tamirmha/General-Purpose-PCB/images/20260401_105210.jpg

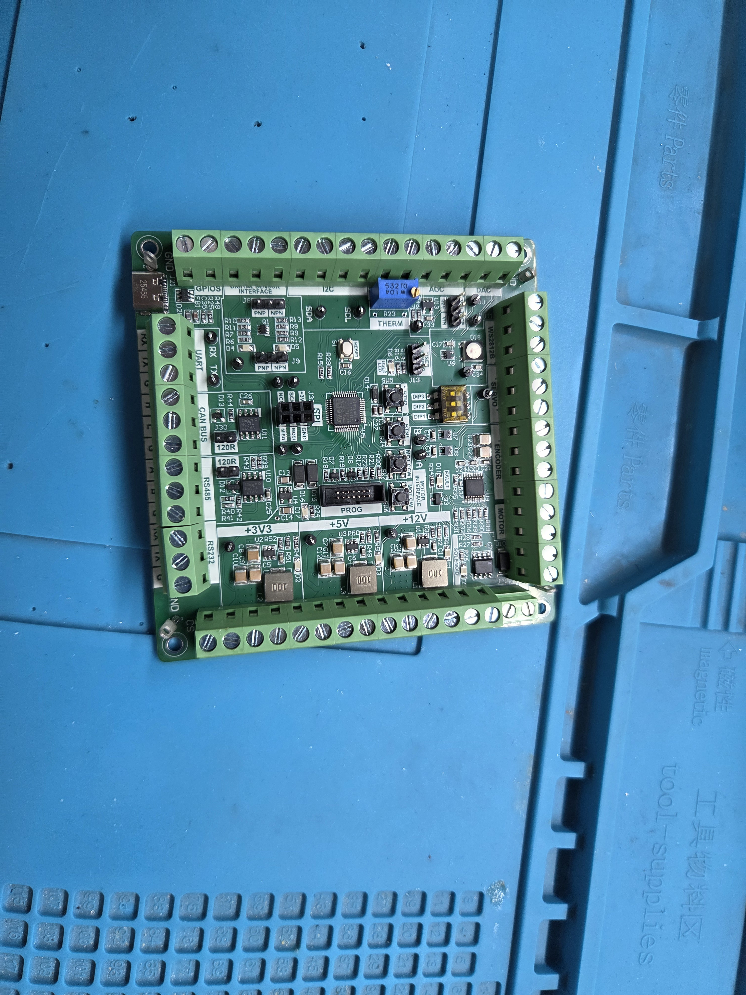
images/20260401_105210.jpg
