tamirmha/General-Purpose-PCB/Hardware/BOM_JLCPCB_PCB.xlsx

Description | Designator | Footprint | LCSC PN | Quantity
0.1 µF ±10% 100V Ceramic Capacitor X7R 0603 (1608 Metric) | C1, C5, C6, C15, C16, C17, C18, C19, C20, C21, C25, C26, C28, C29, C30, C31, C32, C33, C34 | CAP0603 | C77058 | 19
22 µF ±10% 25V Ceramic Capacitor X7R 1210 (3225 Metric) | C2, C3, C4, C7, C8, C9, C10, C11, C12, C22, C23 | CAP1210 | C21397 | 11
1 µF ±10% 35V Ceramic Capacitor X7R 0805 (2012 Metric) | C13, C14 | CAP0805 | C440196 | 2
0.022 µF ±10% 100V Ceramic Capacitor X7R 0603 (1608 Metric) | C24 | CAP0603 | C161234 | 1
4.7 µF ±10% 16V Ceramic Capacitor X7R 0603 (1608 Metric) | C27, C35 | CAP0603 | C389010 | 2
Green 570nm LED Indication - Discrete 2.2V 0805 (2012 Metric) | D1, D2, D3, D4, D5, D6, D9, D17 | LED0805 | C2899888 | 8
16V Clamp 9.37A (8/20µs) Ipp Tvs Diode Surface Mount SC-70-3 (SOT323) | D7, D8 | SC70-3(SOT-323) | C232543 | 2
DIODE SCHOTTKY 40V 3A SMA | D10, D15, D16 | SMA(DO-214AC) | C168859 | 3
Red 633nm LED Indication - Discrete 2V 0805 (2012 Metric) | D11 | LED0805 | C2899997 | 1
RS-485 , 26V, 14V Clamp 17A (8/20µs) Ipp Tvs Diode Surface Mount SOT-23-3 | D12 | SOT23 | C404012 | 1
CAN, CAN FD, TVS Clamp 4A (8/20µs) Ipp Tvs Diode Surface Mount SC-70 | D13 | SOT23 | C3713903 | 1
DIODE ZENER 3.3V 500MW SOD123 | D14 | SOD123 | C151564 | 1
WS2812B - ADDRESSABLE LED RED/GRN/BLUE | D18 | LED5050 | C114586 | 1
DIODE ZENER 9.1V 500MW SOD123 | D19 | SOD123 | C260913 | 1
USB2.0 Data and VBUS, ESD Protection, 17V Clamp 5A (8/20µs) Ipp Tvs Diode Surface Mount SOT-23-6 | D20 | SOT23-6 | C7519 | 1
120 Ohms @ 100 MHz 1 Power Line Ferrite Bead 0603 (1608 Metric) 3A 30mOhm | FB1 | FER0603 | C85831 | 1
TB 5.00mm 2POS TH 18A, 300V, 12-26 AWG Wire | J1, J2, J3, J4, J5, J6, J12, J15, J18, J19, J20, J25, J26, J27 | 1935161 | C3819953 | 14
TB 5.00mm 3POS TH 18A, 300V, 12-26 AWG Wire | J7, J14, J16, J17, J22, J23, J24, J29, J31, J33 | 1935174 | C3816891 | 10
Connector Header Through Hole 3 position 0.100" (2.54mm) | J8, J9, J13, J34 | 3P-2.54mm-MalePins | C5346215 | 4
Connector Header Through Hole 14 position 0.050" (1.27mm) | J11 | 20021511-00014T4LF |  | 1
USB-C (USB TYPE-C) USB 2.0 Receptacle Connector 24 (16+8 Dummy) Position Surface Mount, Right Angle; Through Hole | J21 | 2171790001 | C3197684 | 1
Connector Header Through Hole 2 position 0.100" (2.54mm) | J28, J30 | 2P-2.54mm-MalePins | C2931354 | 2
6 Position Header Connector 0.100" (2.54mm) Through Hole Tin | J32 | 3PX2_2.54MM HEADER |  | 1
10 µH Shielded Drum Core, Wirewound Inductor 4 A 78.5mOhm Max Nonstandard | L1, L2, L3 | SRN6540 | C780191 | 3
MOSFET N/P-CH 30V 0.65A SOT363 | Q1 | SOT363 | C155499 | 1
MOSFET N-CH 60V 9.2A SO-8 | Q2 | SO-8 | C151586 | 1
MOSFET P-CH 50V 130MA SOT23-3 | Q3 | SOT23 | C85202 | 1
MOSFET P-CH 60V 7.2A/23.6A TO252 | Q4 | TO252(DPAK) | C260900 | 1
3.01 kOhms ±1% 0.1W, 1/10W Chip Resistor 0603 (1608 Metric) Moisture Resistant Thick Film | R1 | RES0603 | C137732 | 1
140 kOhms ±1% 0.1W, 1/10W Chip Resistor 0603 (1608 Metric) Moisture Resistant Thick Film | R2 | RES0603 | C185372 | 1
10 kOhms ±1% 0.1W, 1/10W Chip Resistor 0603 (1608 Metric) Moisture Resistant Thick Film | R3, R14, R31, R32, R38, R39, R43, R47, R53 | RES0603 | C98220 | 9
220 Ohms ±1% 0.1W, 1/10W Chip Resistor 0603 (1608 Metric) Moisture Resistant Thick Film | R4, R5, R6, R8, R11, R12, R16, R24, R27 | RES0603 | C107696 | 9
4.7 kOhms ±1% 0.1W, 1/10W Chip Resistor 0603 (1608 Metric) Moisture Resistant Thick Film | R7, R9, R10, R13, R15, R28, R29, R30 | RES0603 | C99782 | 8
22 Ohms ±1% 0.1W, 1/10W Chip Resistor 0603 (1608 Metric) Moisture Resistant Thick Film | R17, R18, R19 | RES0603 | C107701 | 3
100 Ohms ±1% 0.1W, 1/10W Chip Resistor 0603 (1608 Metric) Moisture Resistant Thick Film | R20 | RES0603 | C105588 | 1
0 Ohms Jumper Chip Resistor 0603 (1608 Metric) Moisture Resistant Thick Film | R21, R22, R33, R35, R45 | RES0603 | C100044 | 5
TRIMMER 100K OHM 0.5W PC PIN TOP | R23 | Potentiometer-3296W | C48084 | 1
5.1 kOhms ±1% 0.1W, 1/10W Chip Resistor 0603 (1608 Metric) Moisture Resistant Thick Film | R25, R48 | RES0603 | C105580 | 2
2.94 kOhms ±1% 0.1W, 1/10W Chip Resistor 0603 (1608 Metric) Moisture Resistant Thick Film | R26 | RES0603 | C137748 | 1
590 Ohms ±1% 0.1W, 1/10W Chip Resistor 0603 (1608 Metric) Moisture Resistant Thick Film | R34, R36 | RES0603 | C273786 | 2
120 Ohms ±1% 0.1W, 1/10W Chip Resistor 0603 (1608 Metric) Moisture Resistant Thick Film | R40, R44 | RES0603 | C114640 | 2
10 Ohms ±1% 0.1W, 1/10W Chip Resistor 0603 (1608 Metric) Moisture Resistant Thick Film | R41, R42 | RES0603 | C109318 | 2
20 kOhms ±1% 0.1W, 1/10W Chip Resistor 0603 (1608 Metric) Moisture Resistant Thick Film | R46 | RES0603 | C105575 | 1
162 kOhms ±1% 0.1W, 1/10W Chip Resistor 0603 (1608 Metric) Moisture Resistant Thick Film | R49 | RES0603 | C165760 | 1
30.9 kOhms ±1% 0.1W, 1/10W Chip Resistor 0603 (1608 Metric) Moisture Resistant Thick Film | R50 | RES0603 | C137744 | 1
196 kOhms ±1% 0.1W, 1/10W Chip Resistor 0603 (1608 Metric) Moisture Resistant Thick Film | R51 | RES0603 | C273761 | 1
62 kOhms ±1% 0.1W, 1/10W Chip Resistor 0603 (1608 Metric) Moisture Resistant Thick Film | R52 | RES0603 | C137694 | 1
SWITCH TACTILE SPST-NO 0.05A 12V | S1 | PTS815SJM250SMTRLFS | C2689510 | 1
SWITCH SLIDE DIP SPST 0.1A 20V | SW3 | 219-3LPSTR | C2961925 | 1
SWITCH TACTILE SPST-NO 0.05A 12V | SW4, SW5, SW6, SW7 | PTS647SN38SMTR2 LFS | C2799279 | 4
TEST POINT RING, BACK - TH | TP1, TP2, TP3, TP4, TP7, TP8, TP11, TP12, TP13, TP14, TP15, TP16, TP17, TP18, TP19, TP20, TP21, TP26, TP27 | 5001 | C238122 | 19
PC TEST POINT LOOP | TP22, TP23, TP24, TP25 | 4952 | C238118 | 4
IC REG BUCK ADJ 2A TSOT23-6 | U1, U2, U3 | TSOT26 (TSOT-23-6) | C2071868 | 3
Linear Voltage Regulator IC Positive Fixed 1 Output 250mA SOT-23-5 | U4 | SOT23-5 | C80670 | 1
ARM® Cortex®-M0+ STM32G0 Microcontroller IC 32-Bit 64MHz 128KB (128K x 8) FLASH 48-LQFP (7x7) | U5 | LQFP-48(7x7) | C2847904 | 1
Logic Level Shifter, 5V <> 3.3V, Single Supply, SOT-23 | U6, U7, U8 | SC-70-5 | C78541 | 3
Unipolar Motor Driver NMOS PWM 16-HTSSOP | U9 | HTSSOP-16 | C575551 | 1
1/1 Transceiver Half RS422, RS485 8-SOIC | U10 | SOIC-8 | C58890 | 1
1/1 Transceiver Half CANbus 8-SOIC | U11 | SOIC-8 | C30530 | 1
2/2 Transceiver Full RS232 16-TSSOP | U12 | TSSOP-16 | C406863 | 1
Standard (General Purpose) Amplifier 1 Circuit Rail-to-Rail SOT-23-5, VIN 2.7V - 16V | U13 | SOT23-5 | C4368903 | 1
