tamirmha/General-Purpose-PCB/Docs/GENERAL TESTING BOARD-REV00 - Schematics.PDF

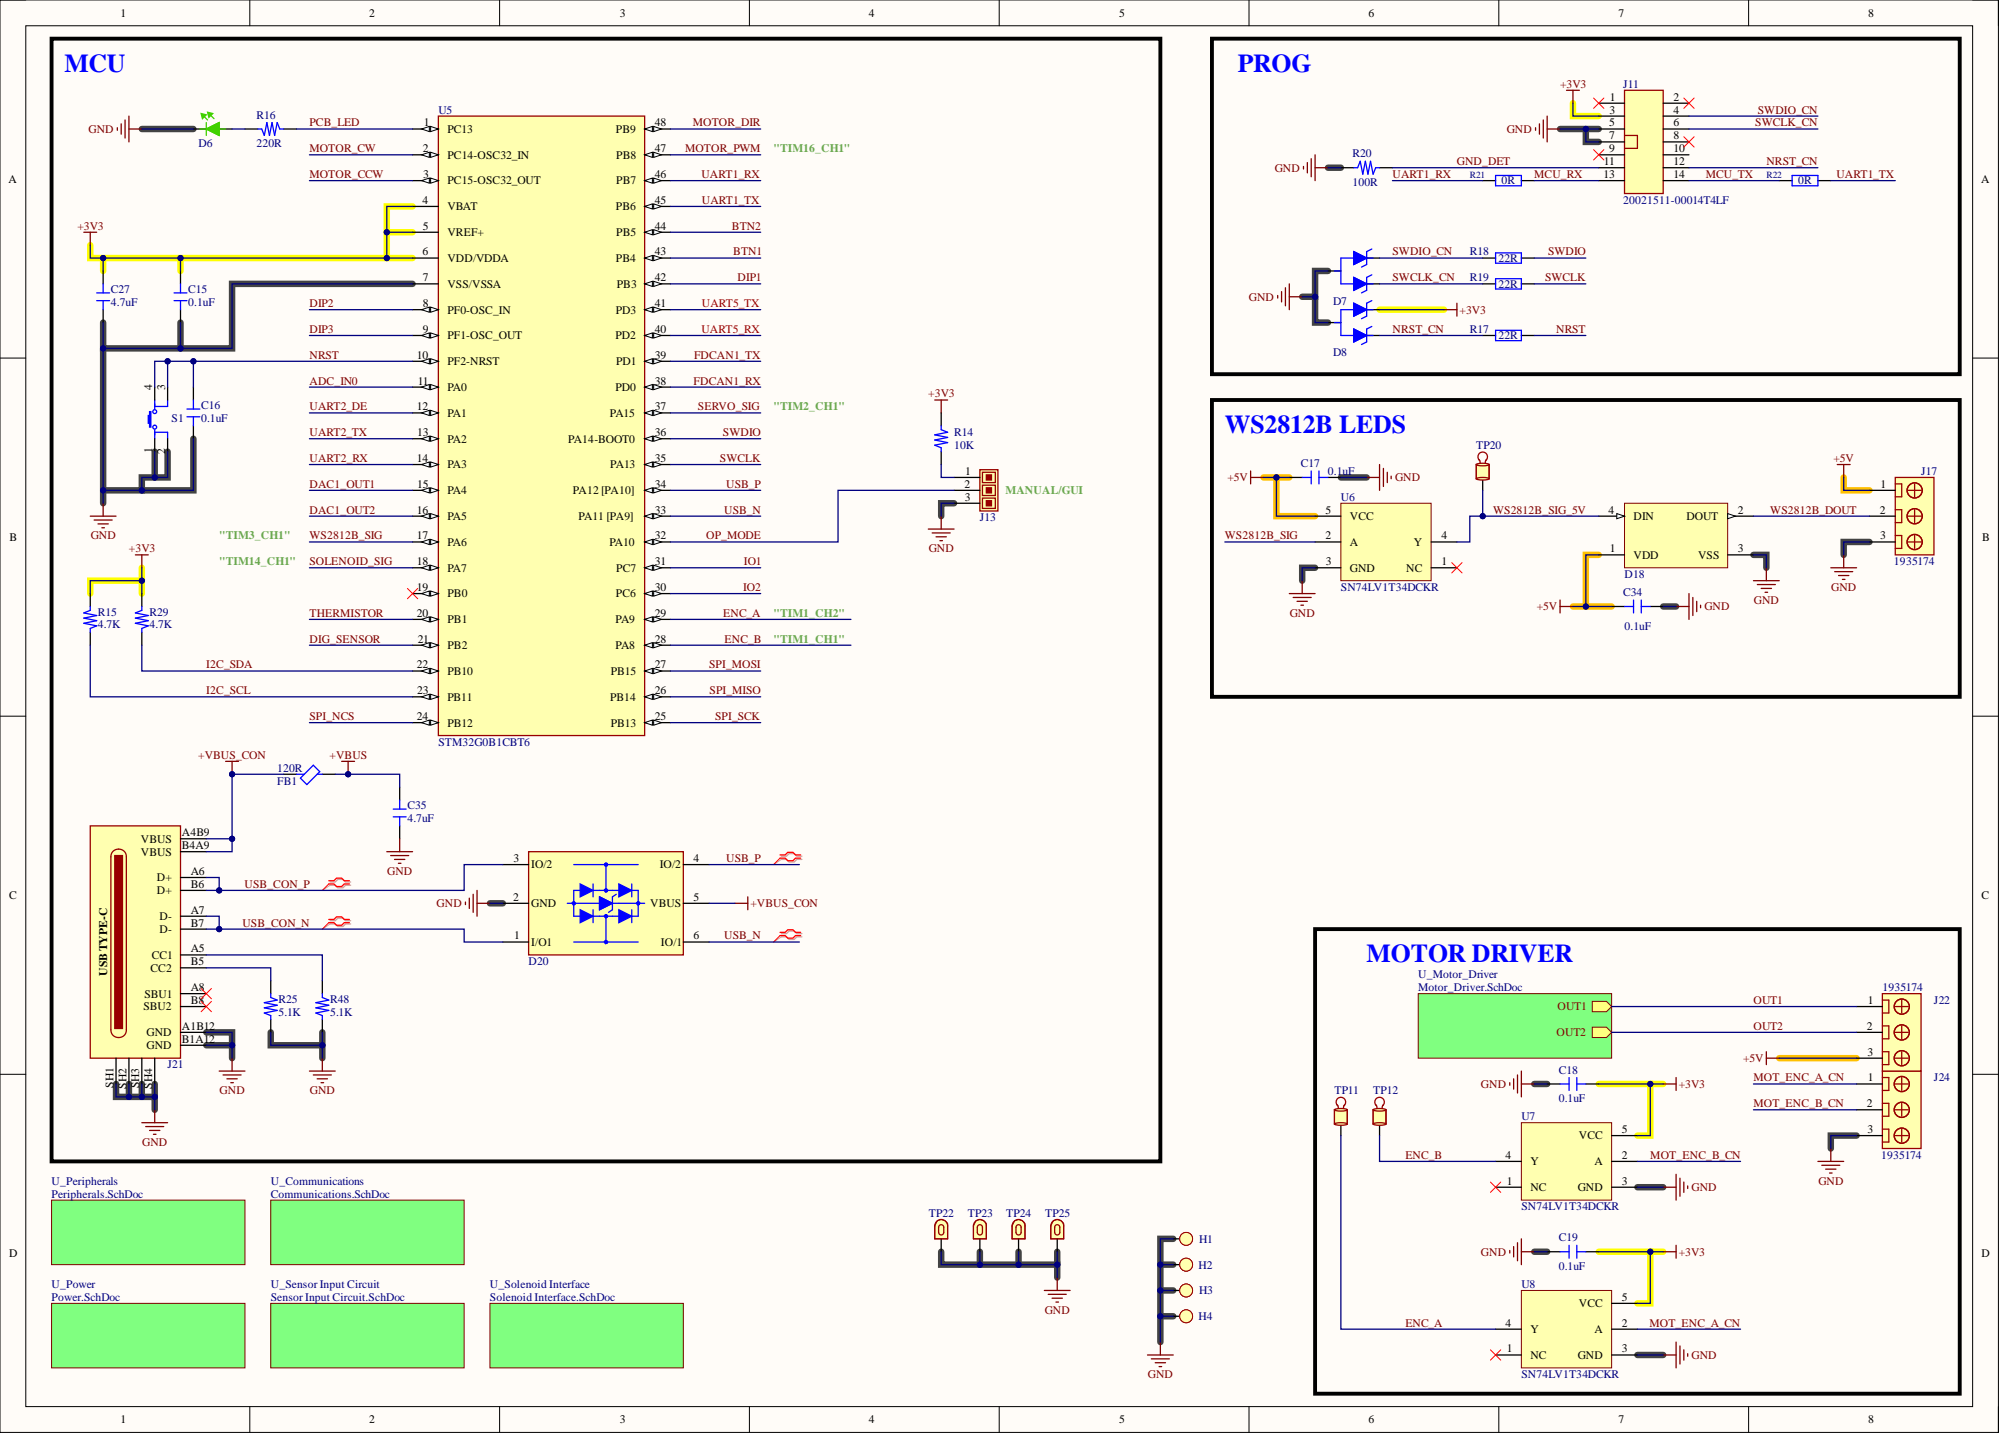
[picture p9: page 1]

VREF+ 5

VSS/VSSA 7

ADC_IN0 | | PA0 11

U_Sensor Input Circuit
Sensor Input Circuit.SchDoc

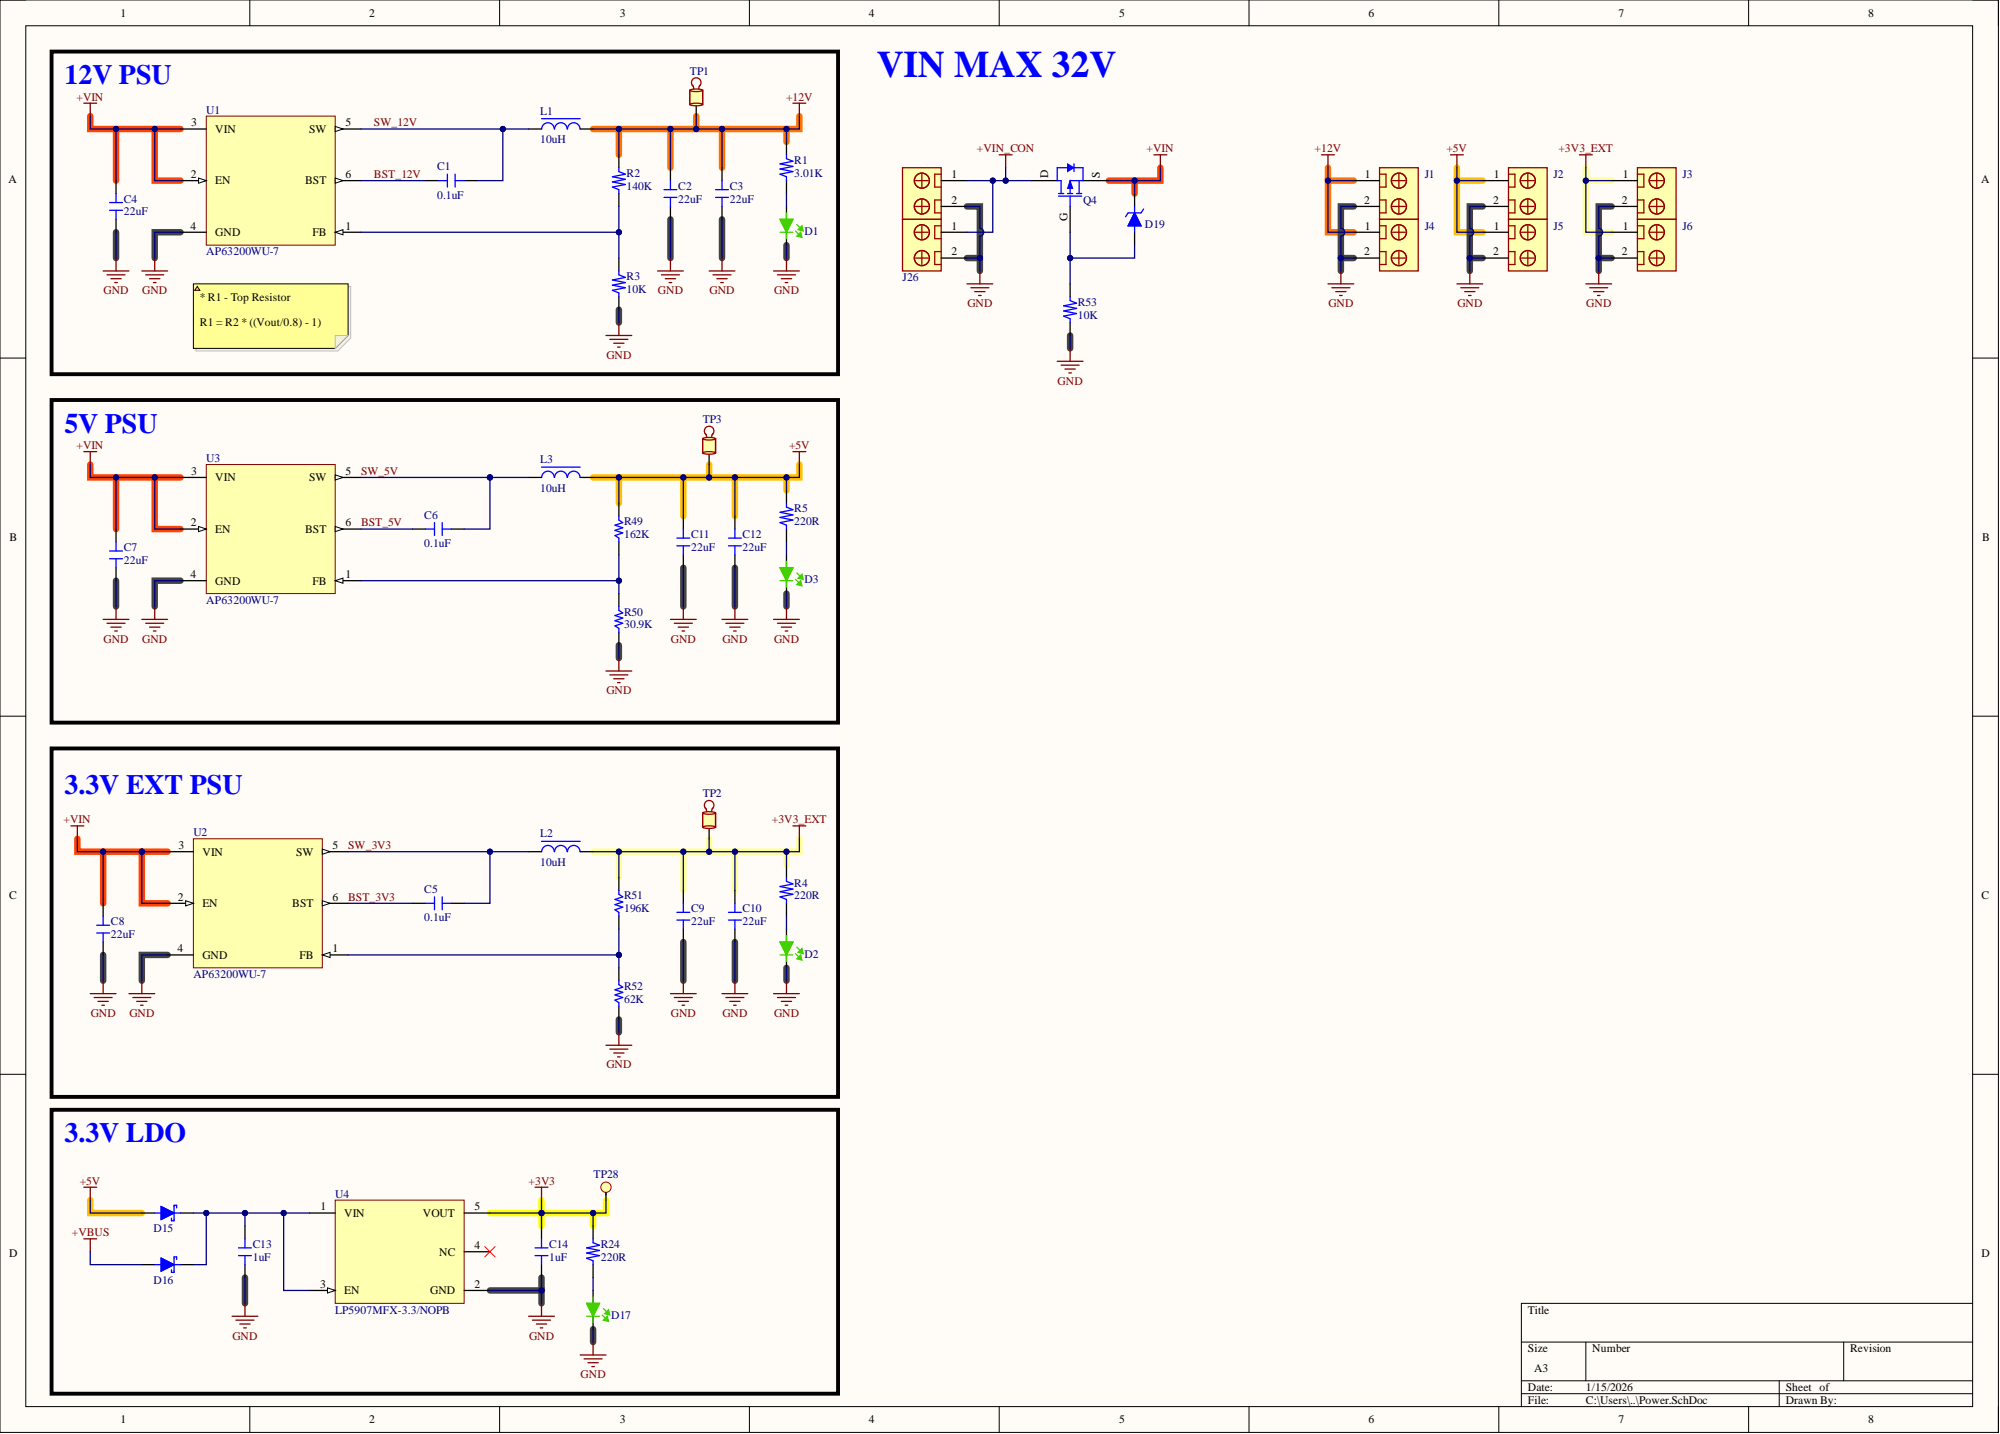
[picture p10: page 2]

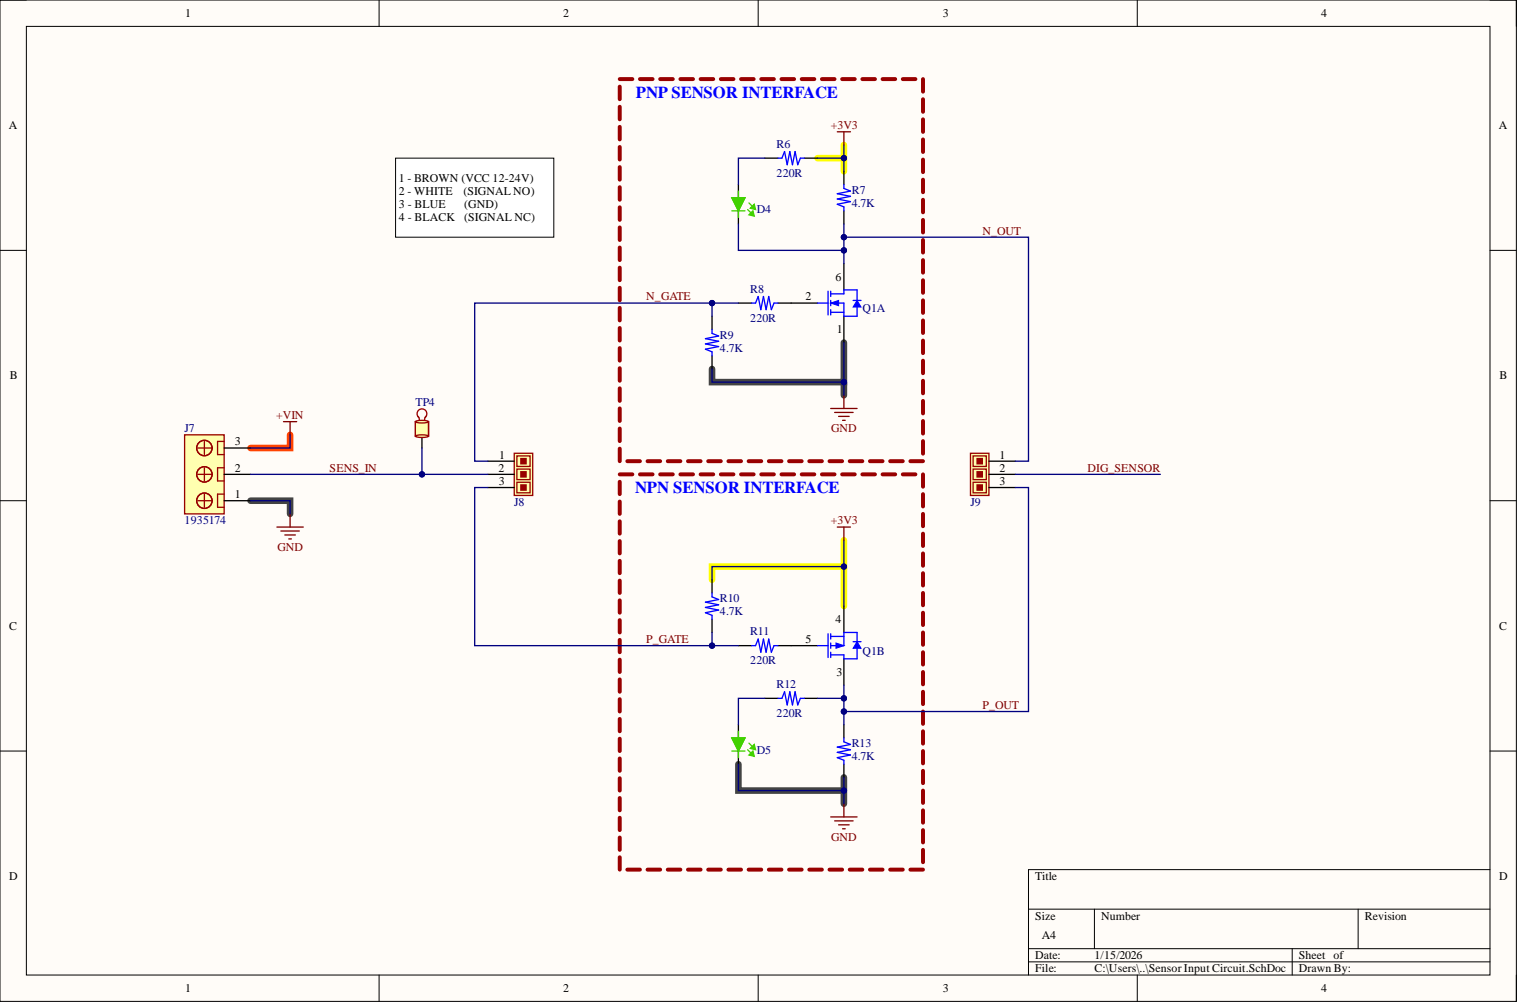
[picture p11: page 3]

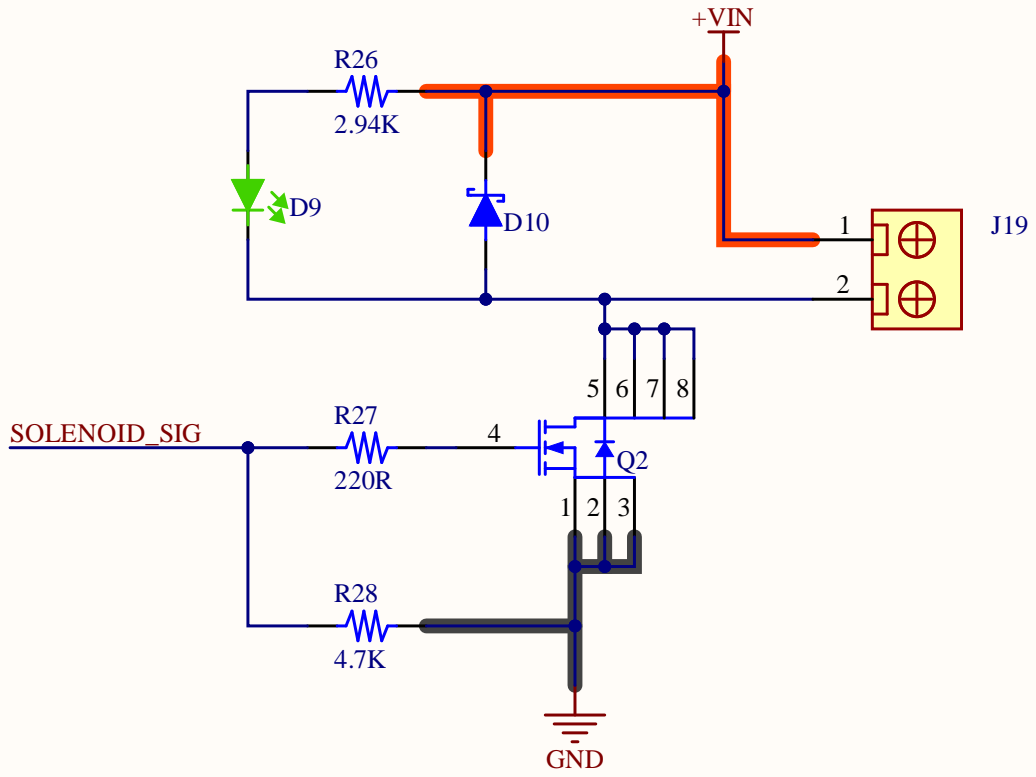
[picture p12: page 4]

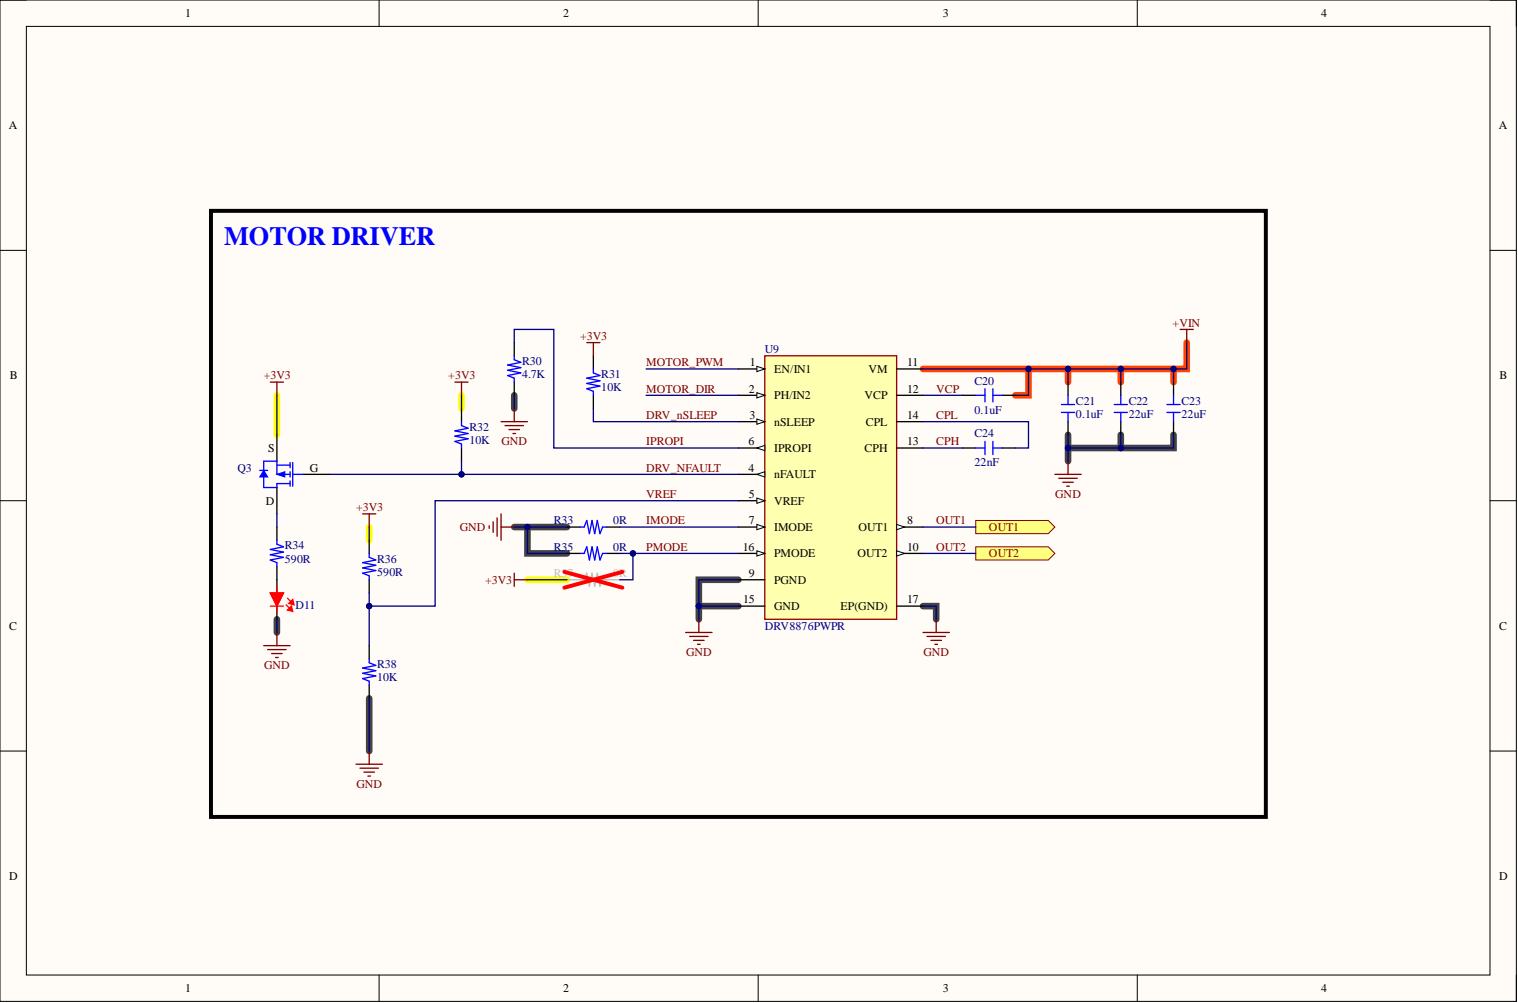
[picture p13: page 5]

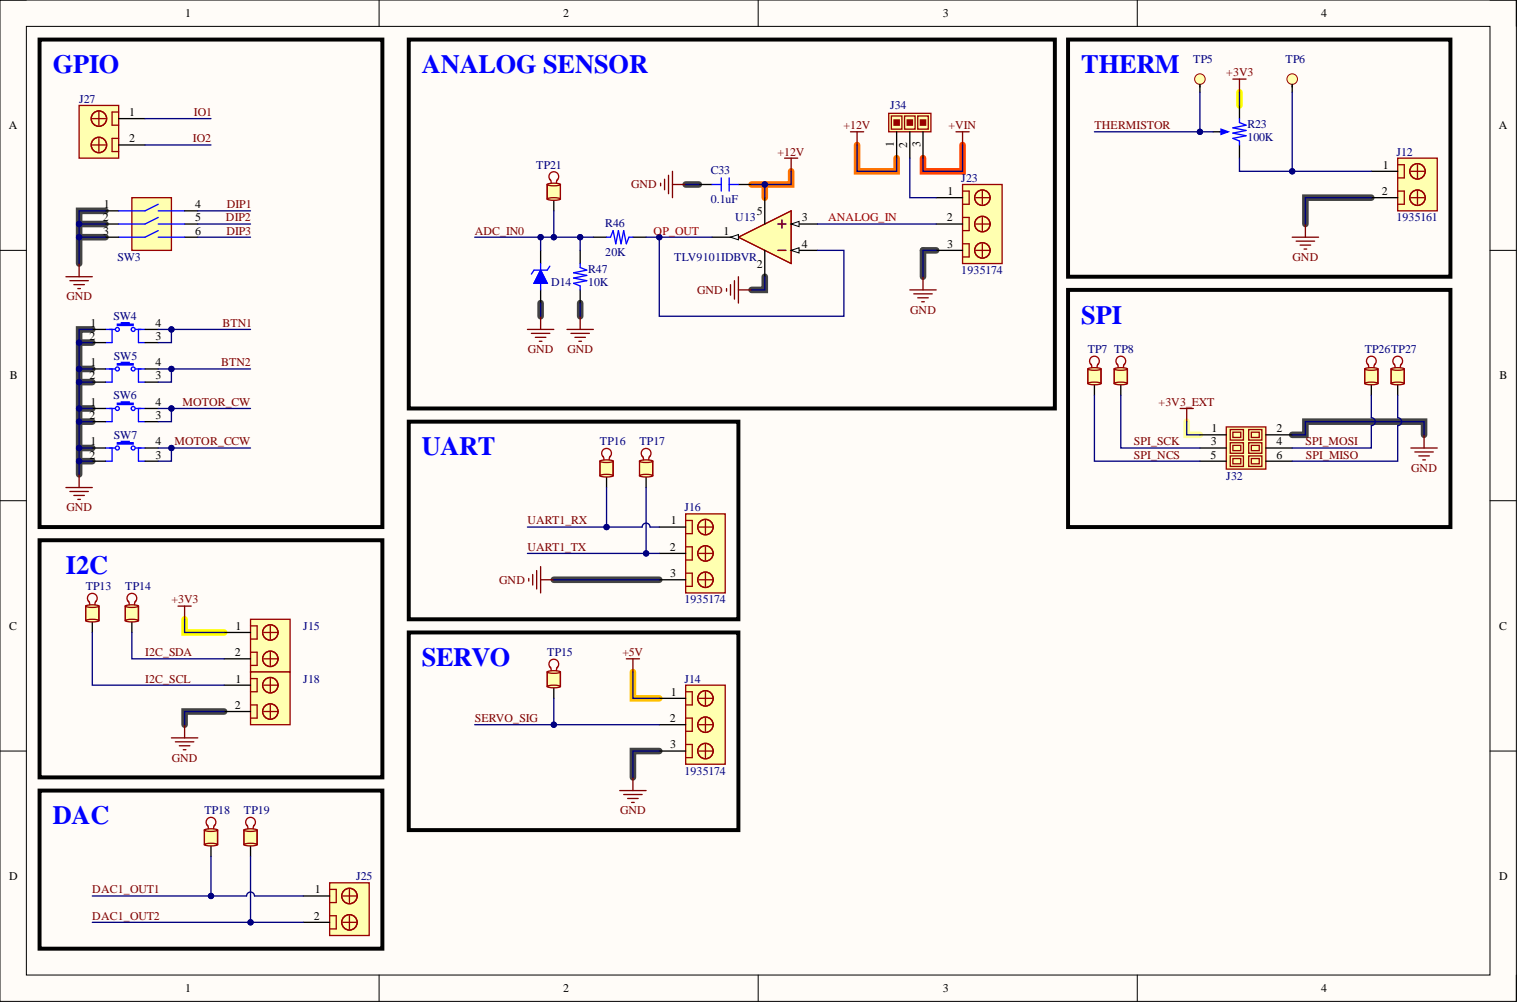
[picture p14: page 6]

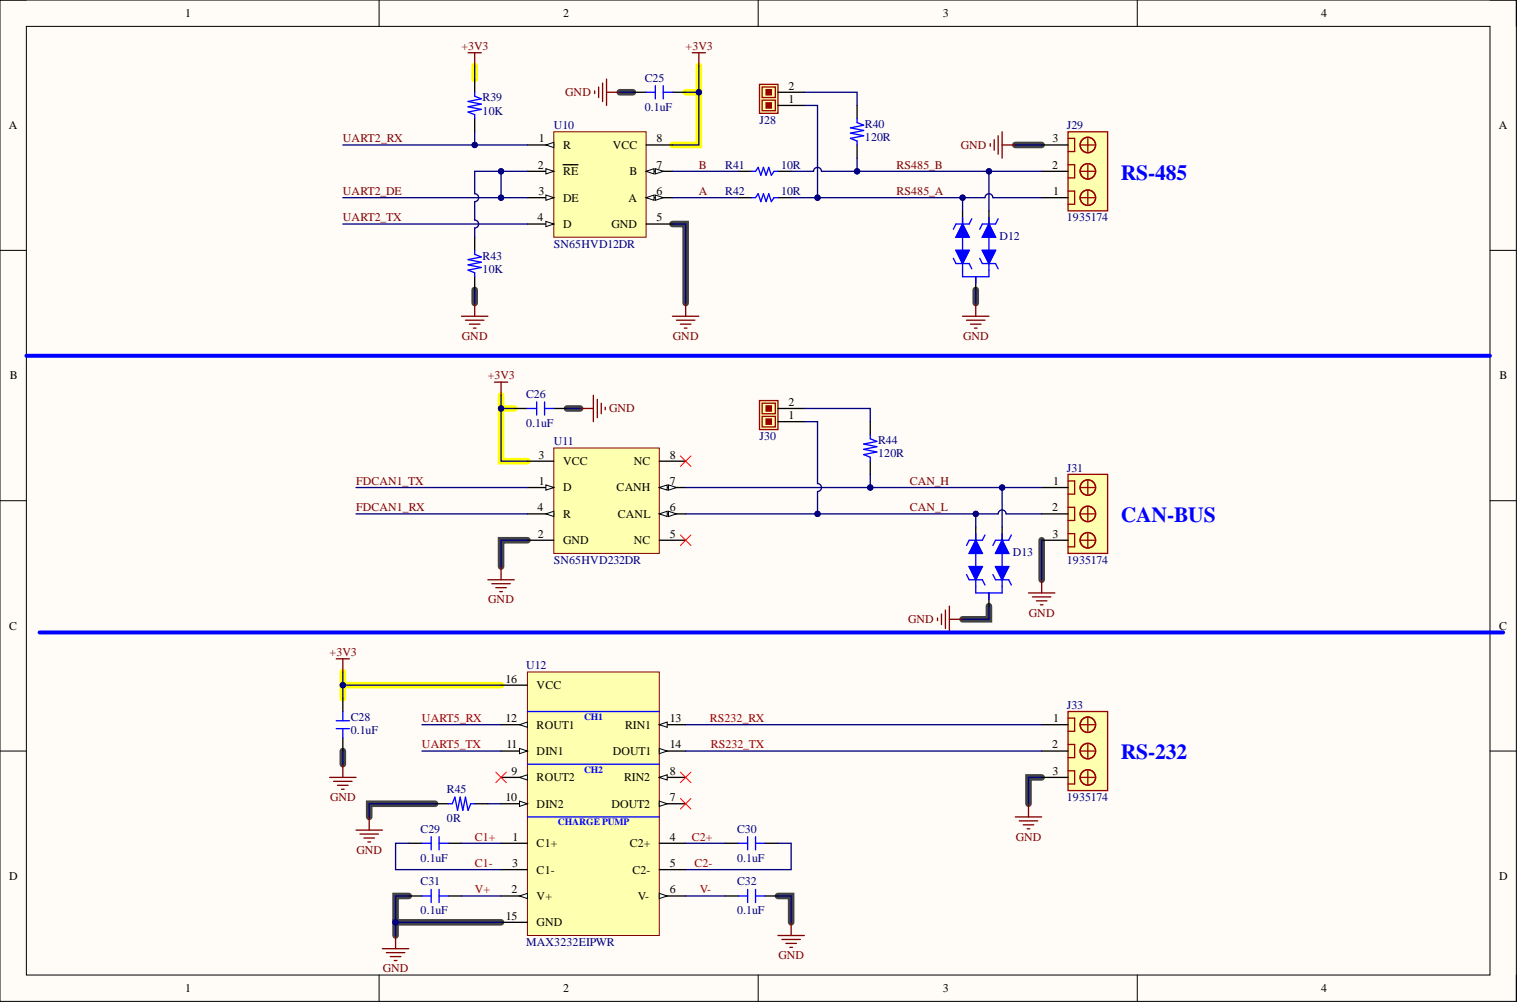
[picture p15: page 7]
