tamirmha/General-Purpose-PCB/Docs/GENERAL TESTING BOARD-REV00 - Fabrication.PDF

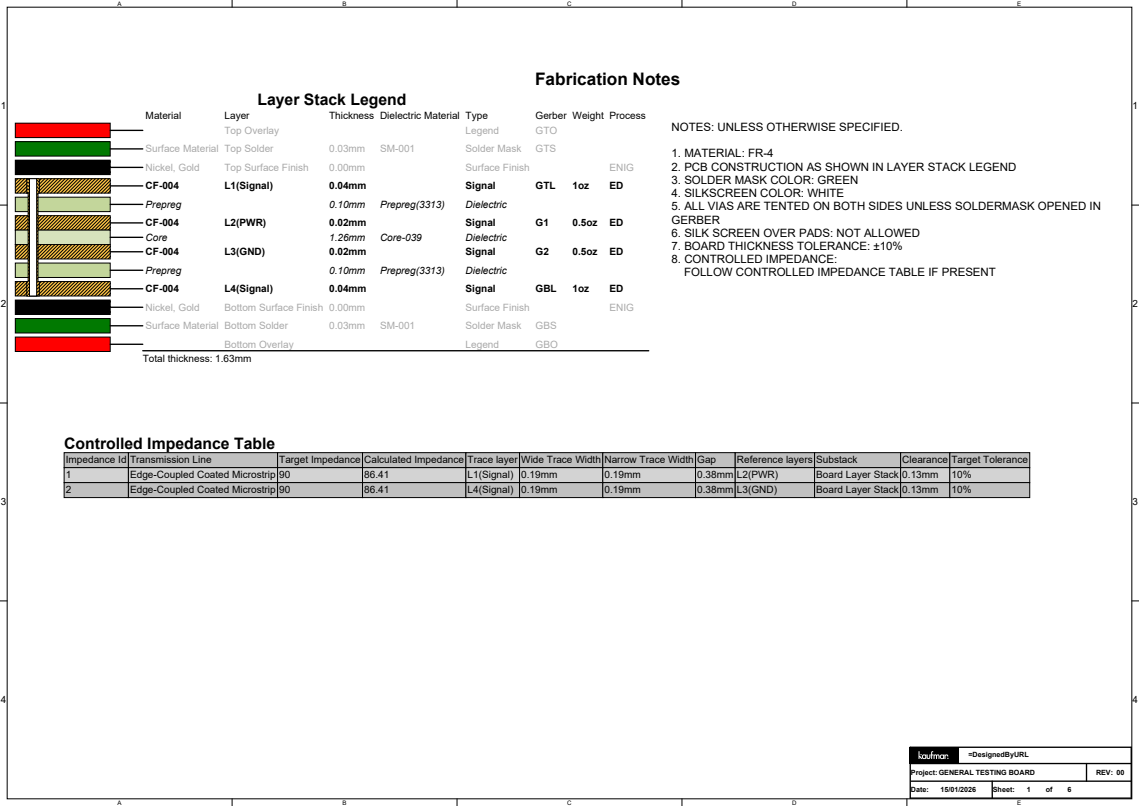
[picture p16: page 1]

NOTES: UNLESS OTHERWISE SPECIFIED.

1. MATERIAL: FR-4
2. PCB CONSTRUCTION AS SHOWN IN LAYER STACK LEGEND
3. SOLDER MASK COLOR: GREEN
4. SILKSCREEN COLOR: WHITE
5. ALL VIAS ARE TENTED ON BOTH SIDES UNLESS SOLDERMASK OPENED IN
GERBER
6. SILK SCREEN OVER PADS: NOT ALLOWED
7. BOARD THICKNESS TOLERANCE: ±10%
8. CONTROLLED IMPEDANCE:
FOLLOW CONTROLLED IMPEDANCE TABLE IF PRESENT

Impedance Id | Transmission Line | Target Impedance | Calculated Impedance | Trace layer | Wide Trace Width | Narrow Trace Width | Gap | Reference layers | Substack | Clearance | Target Tolerance
1 | Edge-Coupled Coated Microstrip | 90 | 86.41 | L1(Signal) | 0.19mm | 0.19mm | 0.38mm | L2(PWR) | Board Layer Stack | 0.13mm | 10%
2 | Edge-Coupled Coated Microstrip | 90 | 86.41 | L4(Signal) | 0.19mm | 0.19mm | 0.38mm | L3(GND) | Board Layer Stack | 0.13mm | 10%

Project:GENERAL TESTING BOARD | REV: 00

Date: 15/01/2026 | Sheet: 1 of 6

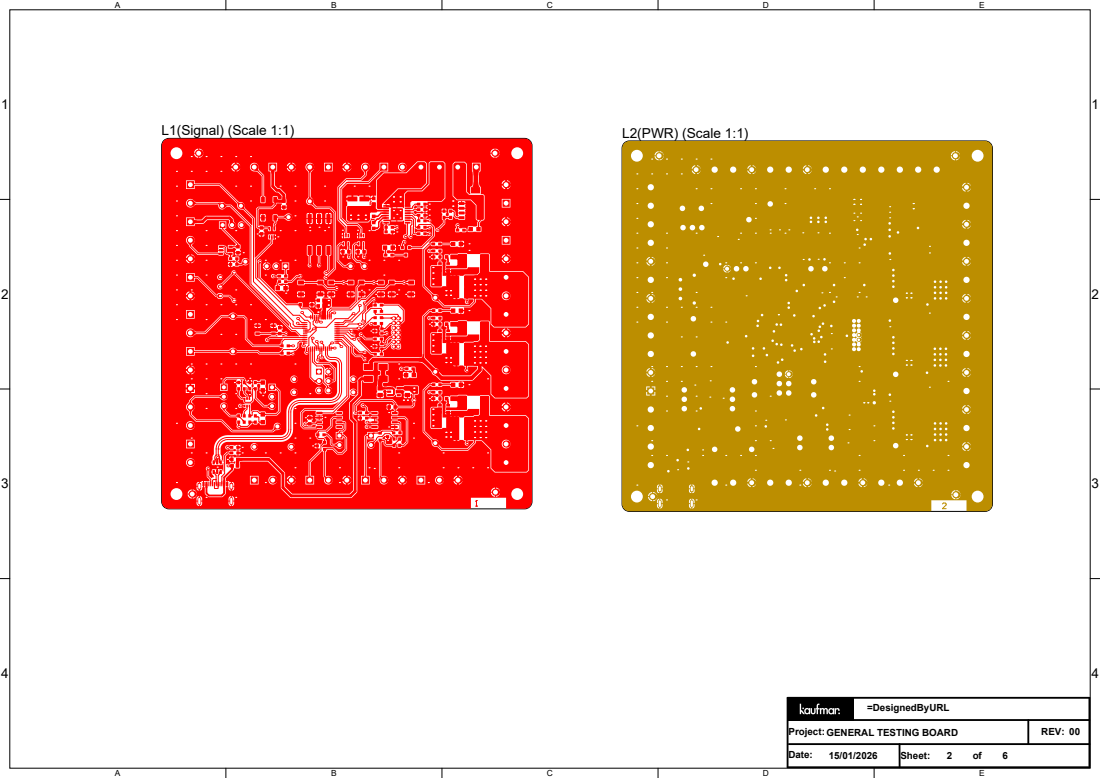
[picture p17: page 2]

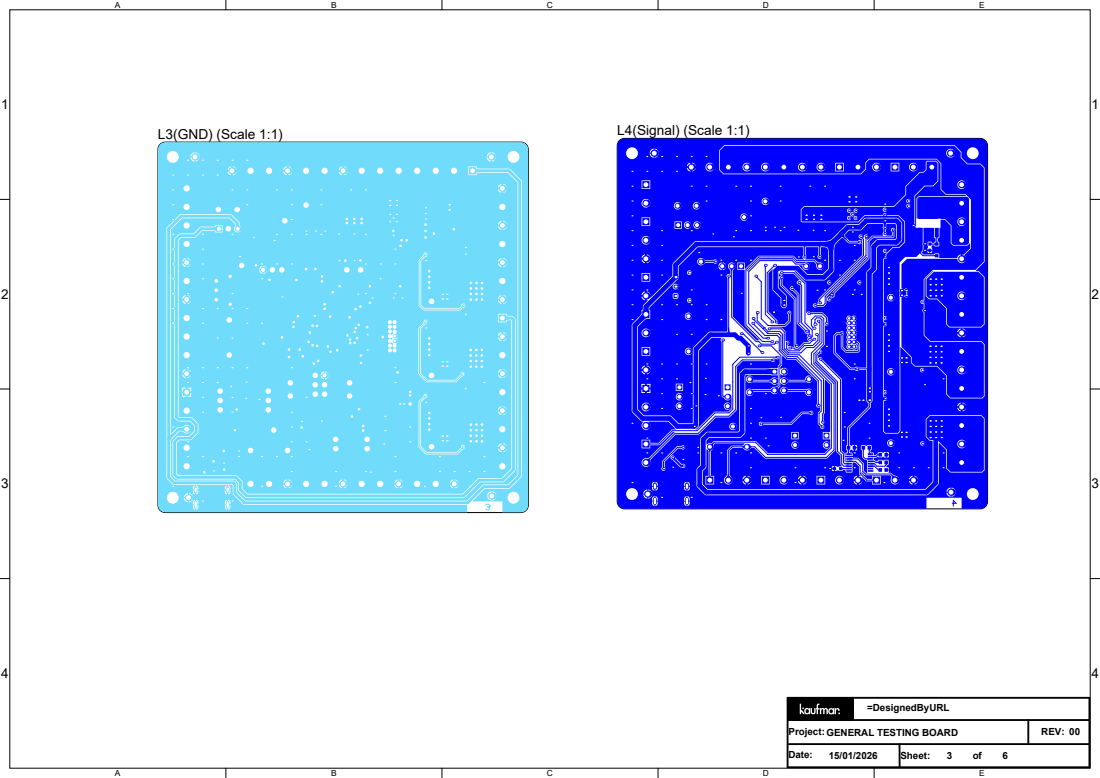
[picture p18: page 3]

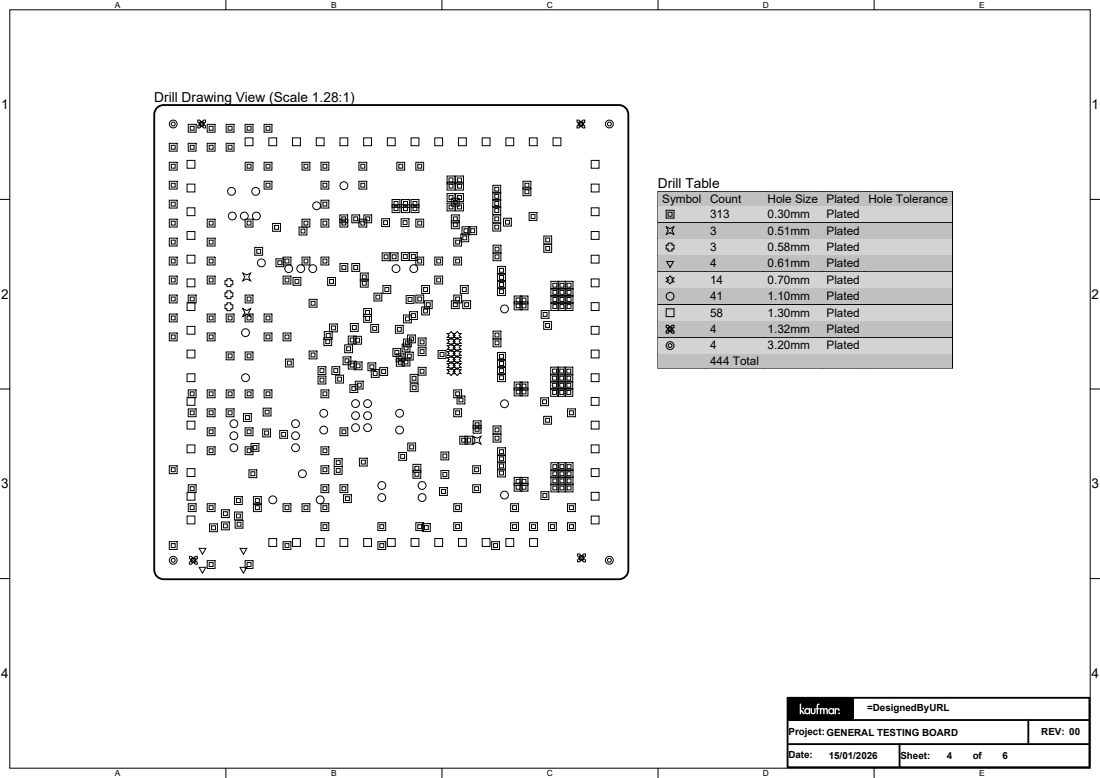
[picture p19: page 4]

Drill Drawing View (Scale 1.28:1)

Symbol | Count | Hole Size | Plated | Hole Tolerance

313 | 0.30mm | Plated
3 | 0.51mm | Plated
3 | 0.58mm | Plated
4 | 0.61mm | Plated
14 | 0.70mm | Plated
41 | 1.10mm | Plated
58 | 1.30mm | Plated
4 | 1.32mm | Plated
4 | 3.20mm | Plated
444 Total

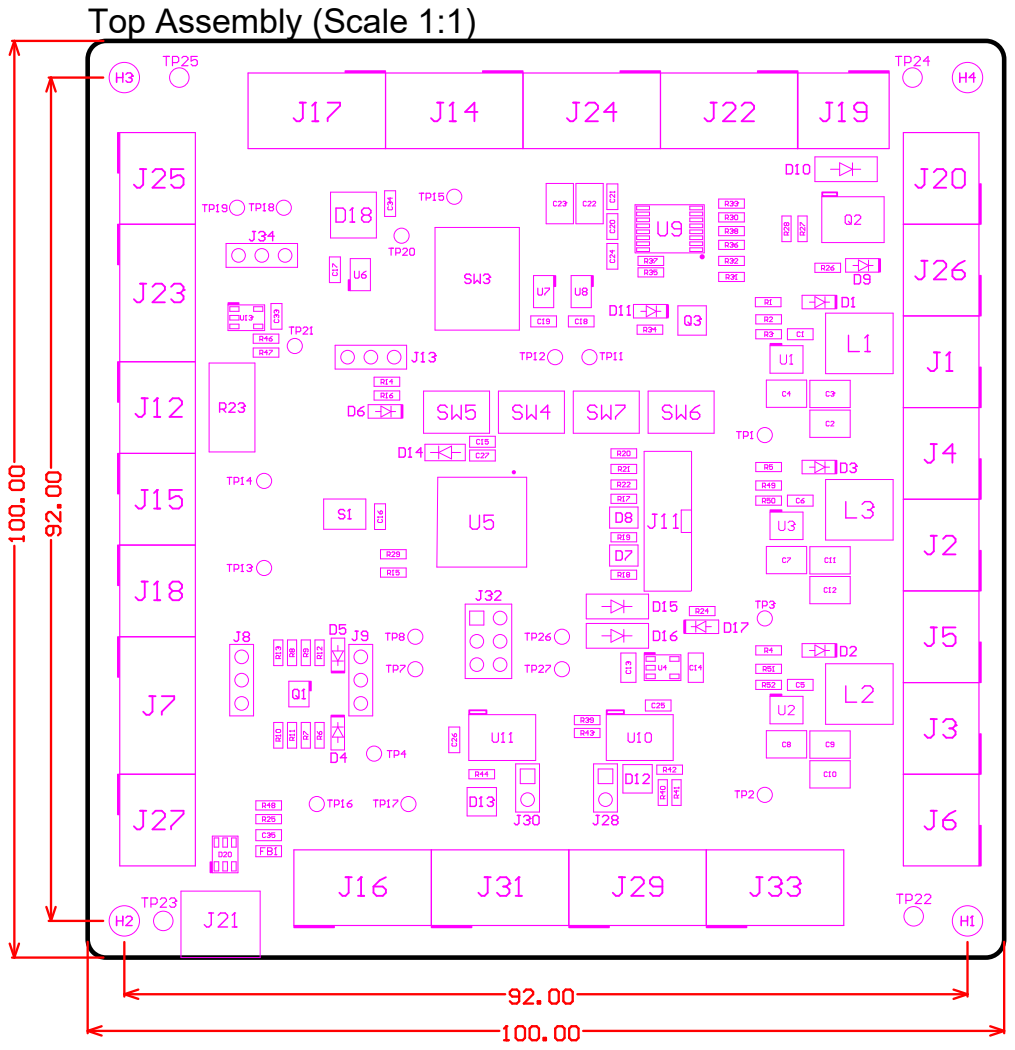
[picture p20: page 5]

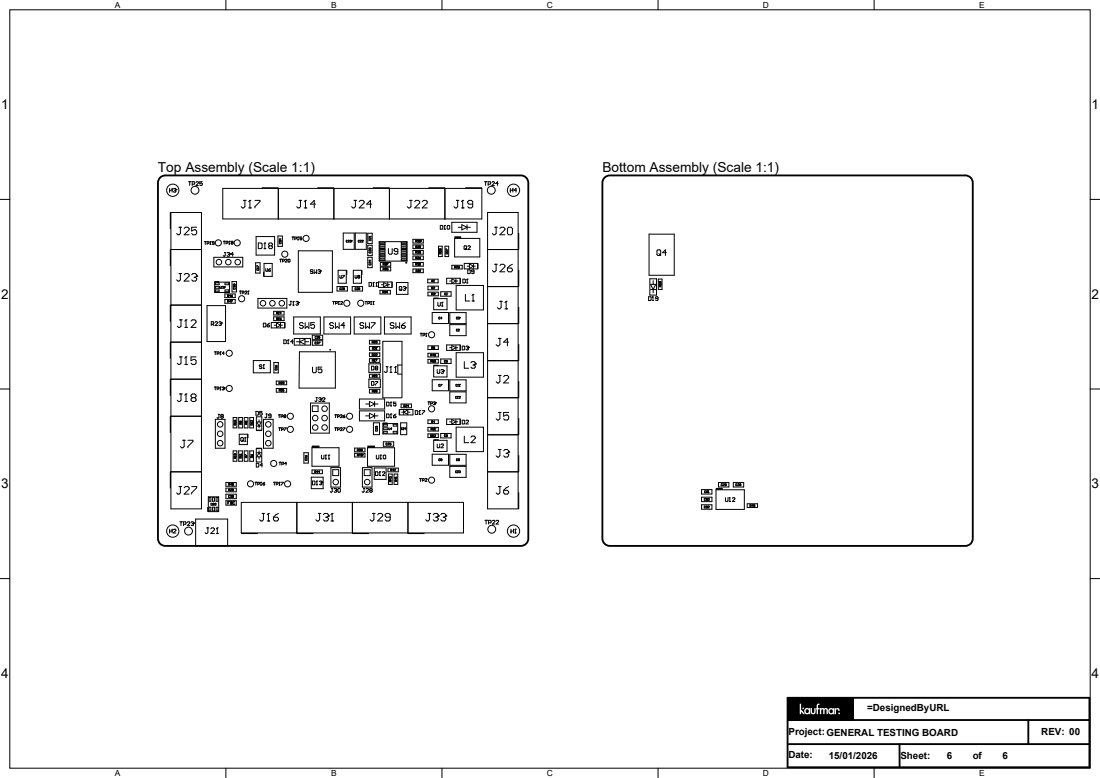
[picture p21: page 6]
