tamirmha/General-Purpose-PCB/Docs/GENERAL TESTING BOARD-REV00 - Assembly.PDF

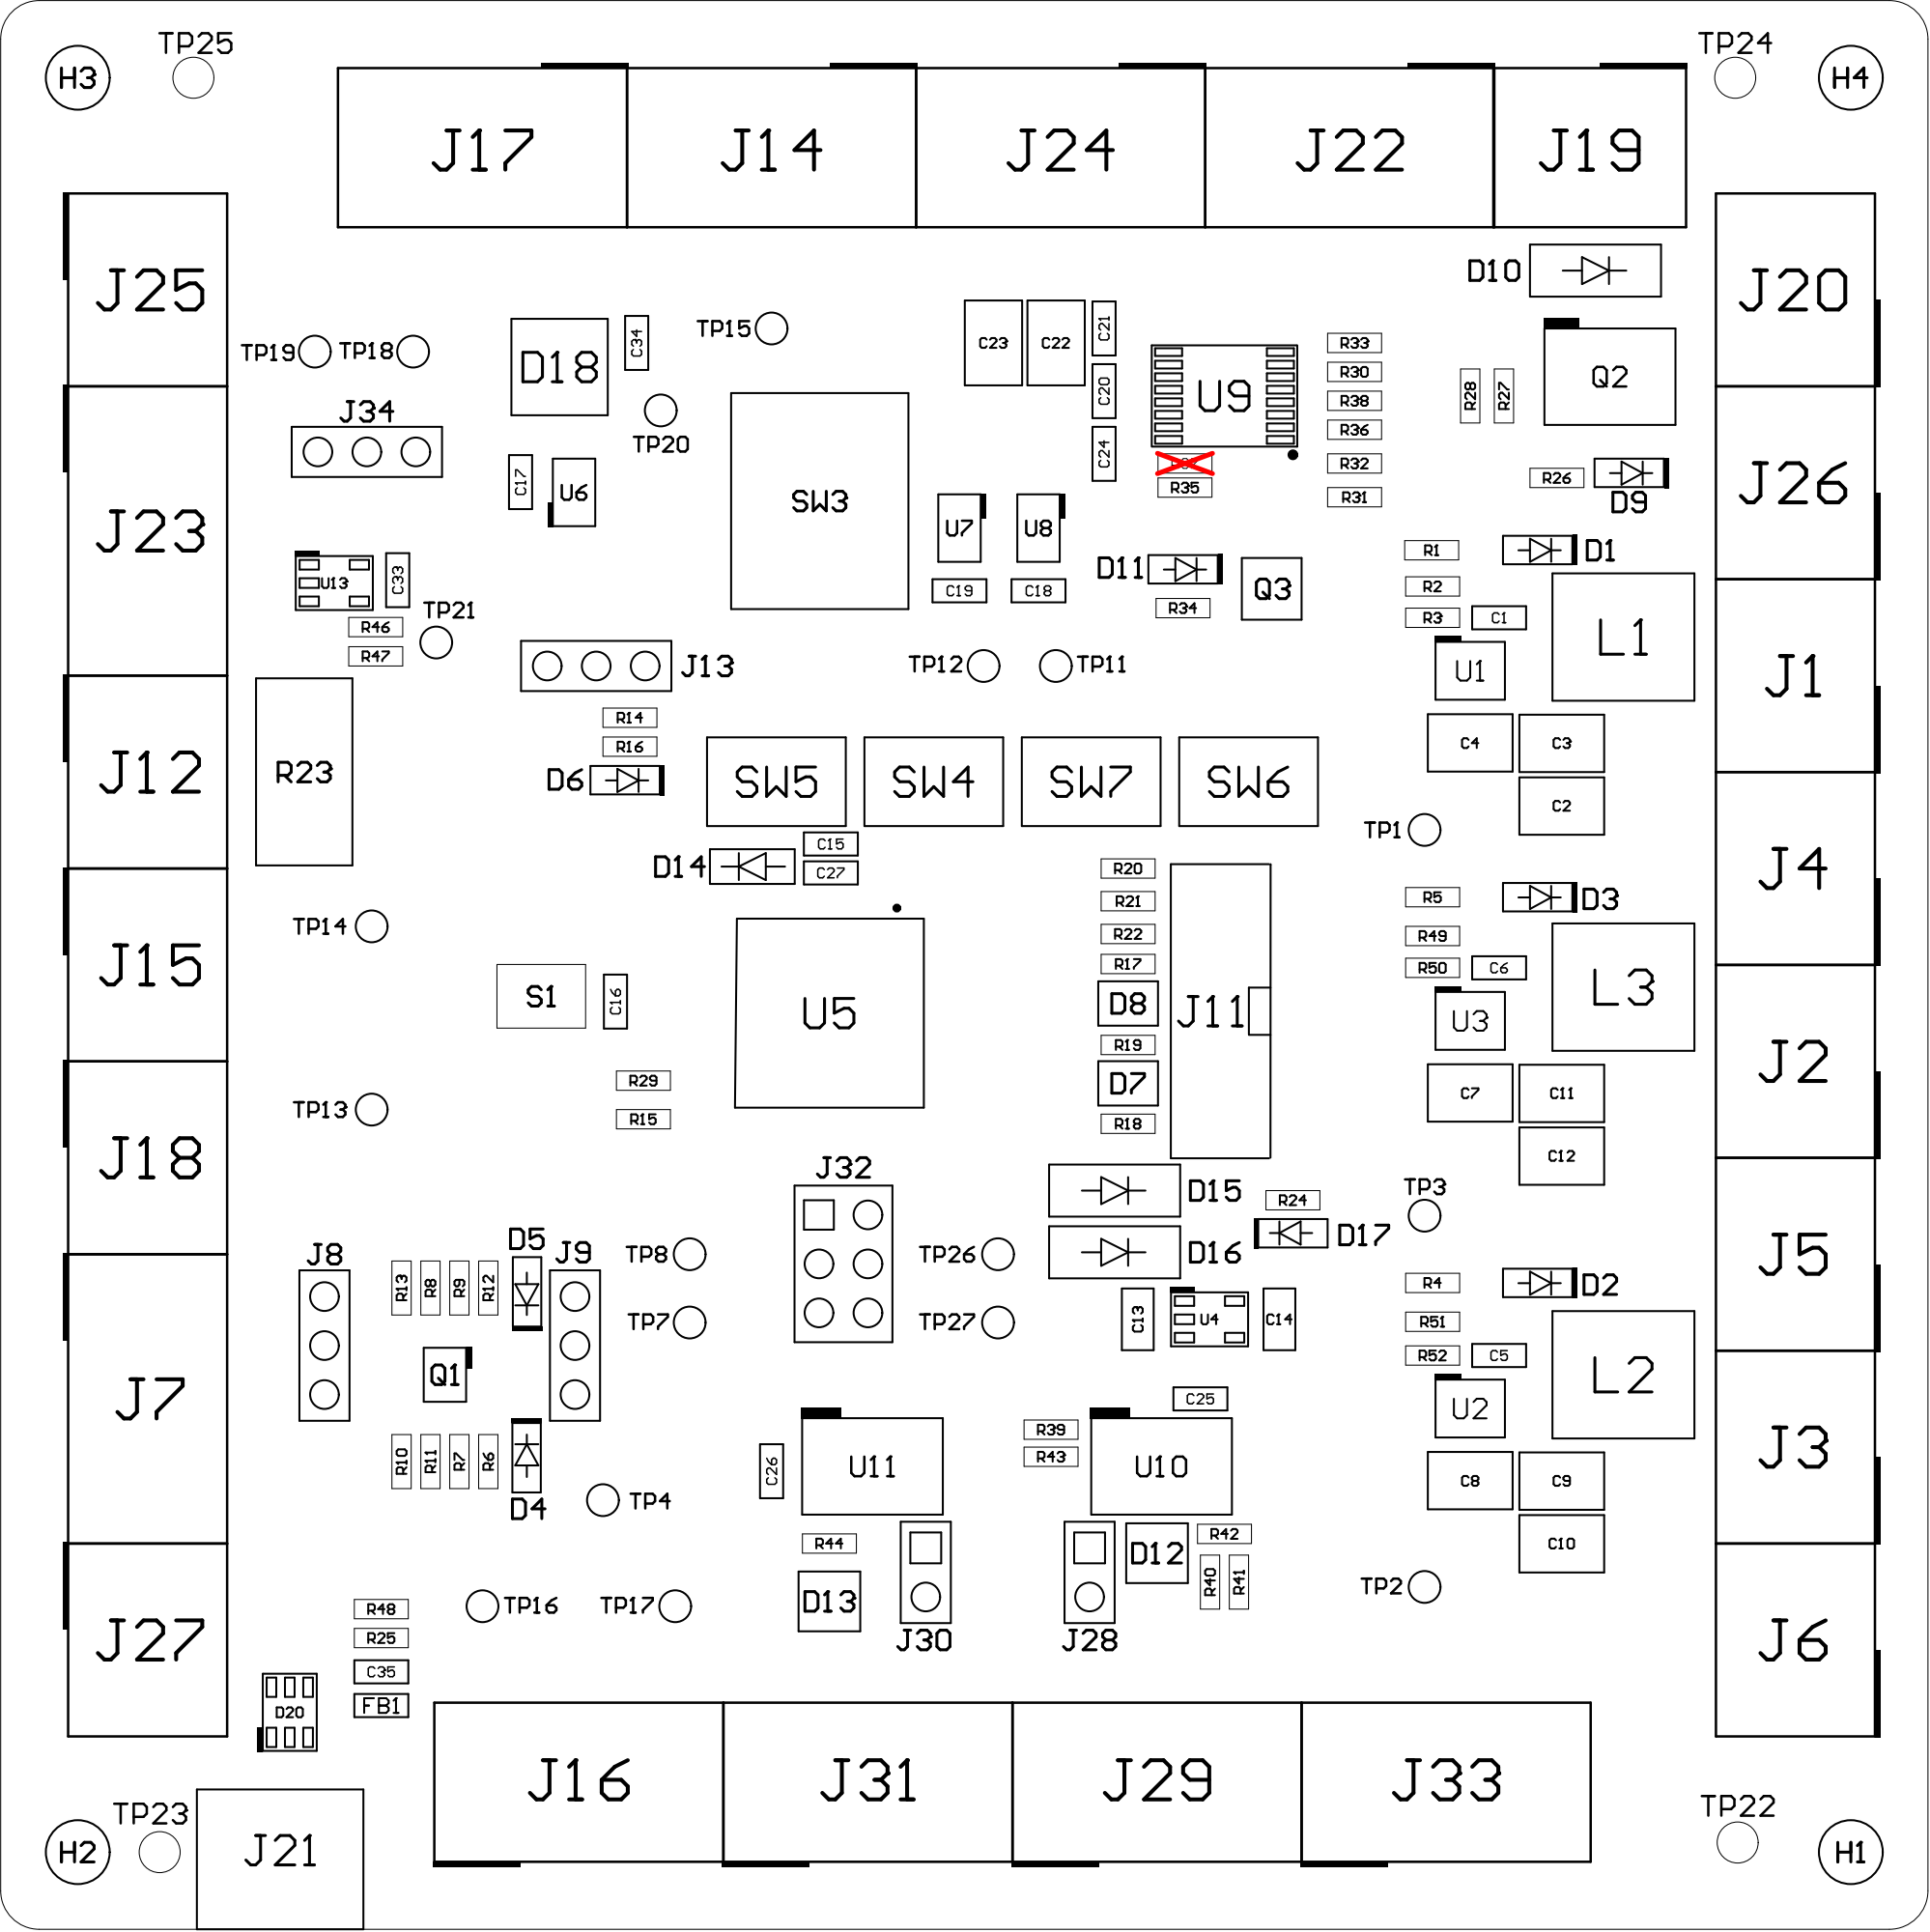
[picture p22: page 1]

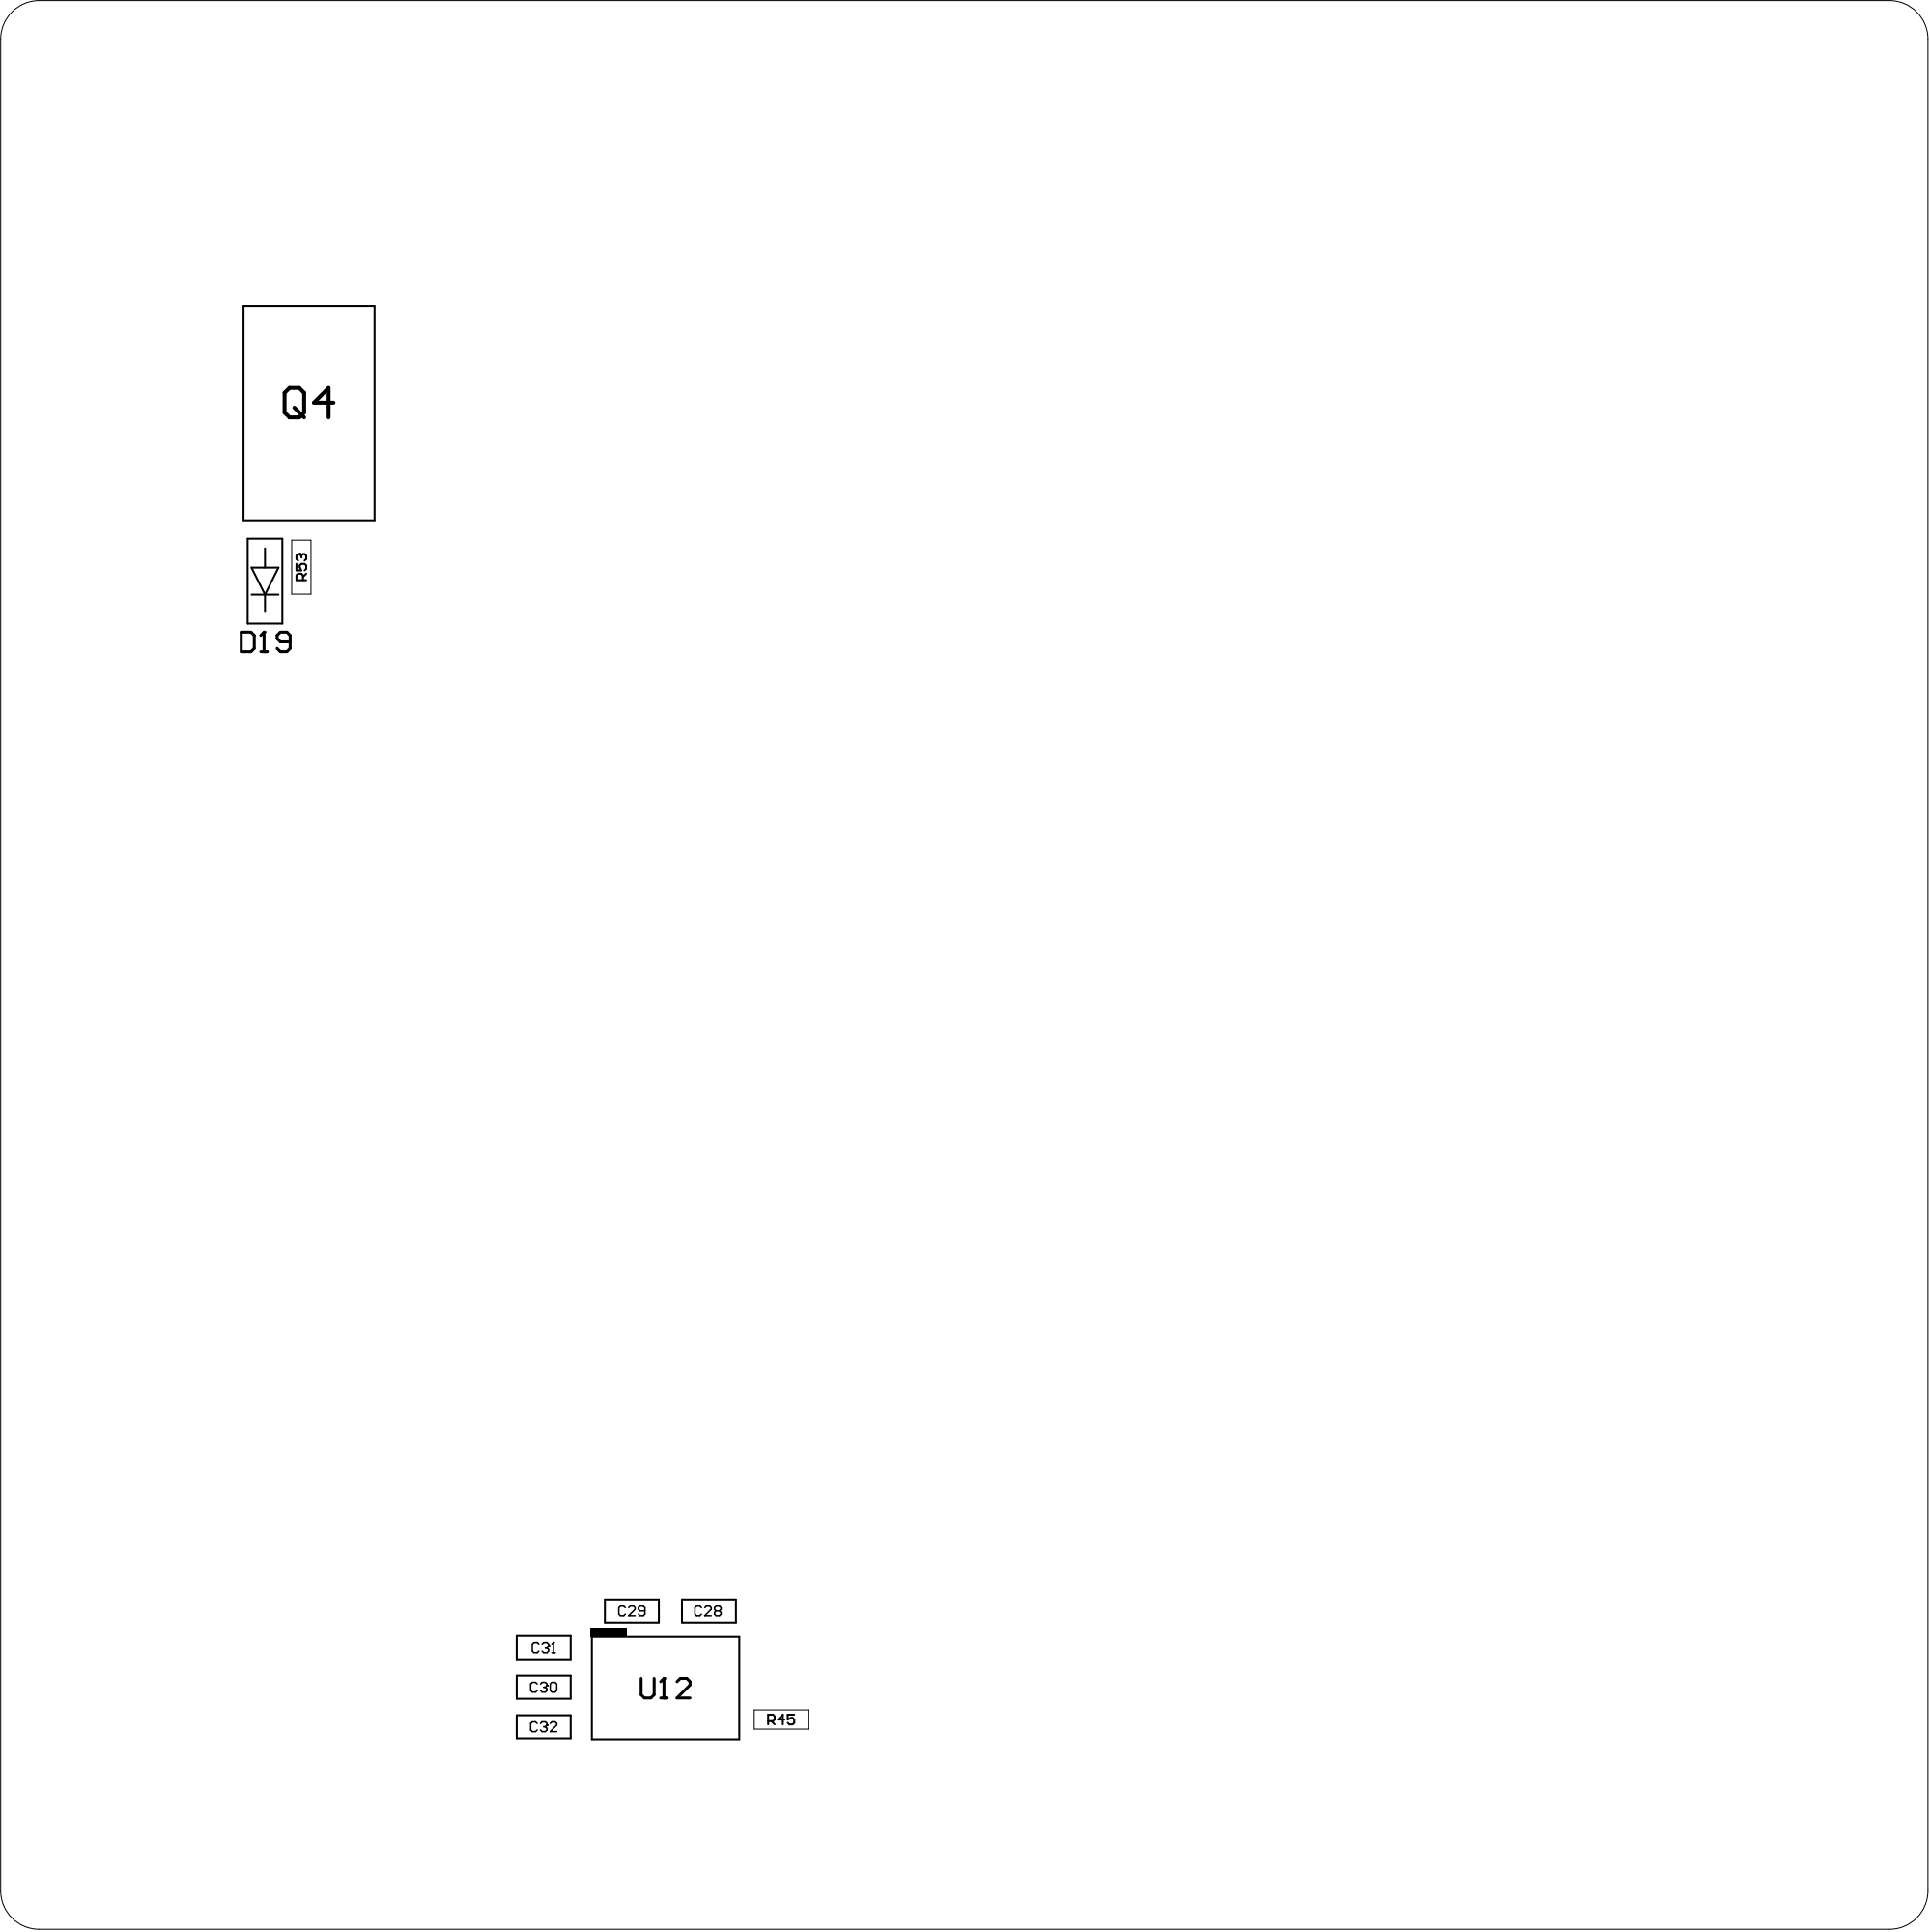
[picture p23: page 2]
