tamirmha/General-Purpose-PCB/Docs/GENERAL TESTING BOARD-REV00 - PCB View.PDF

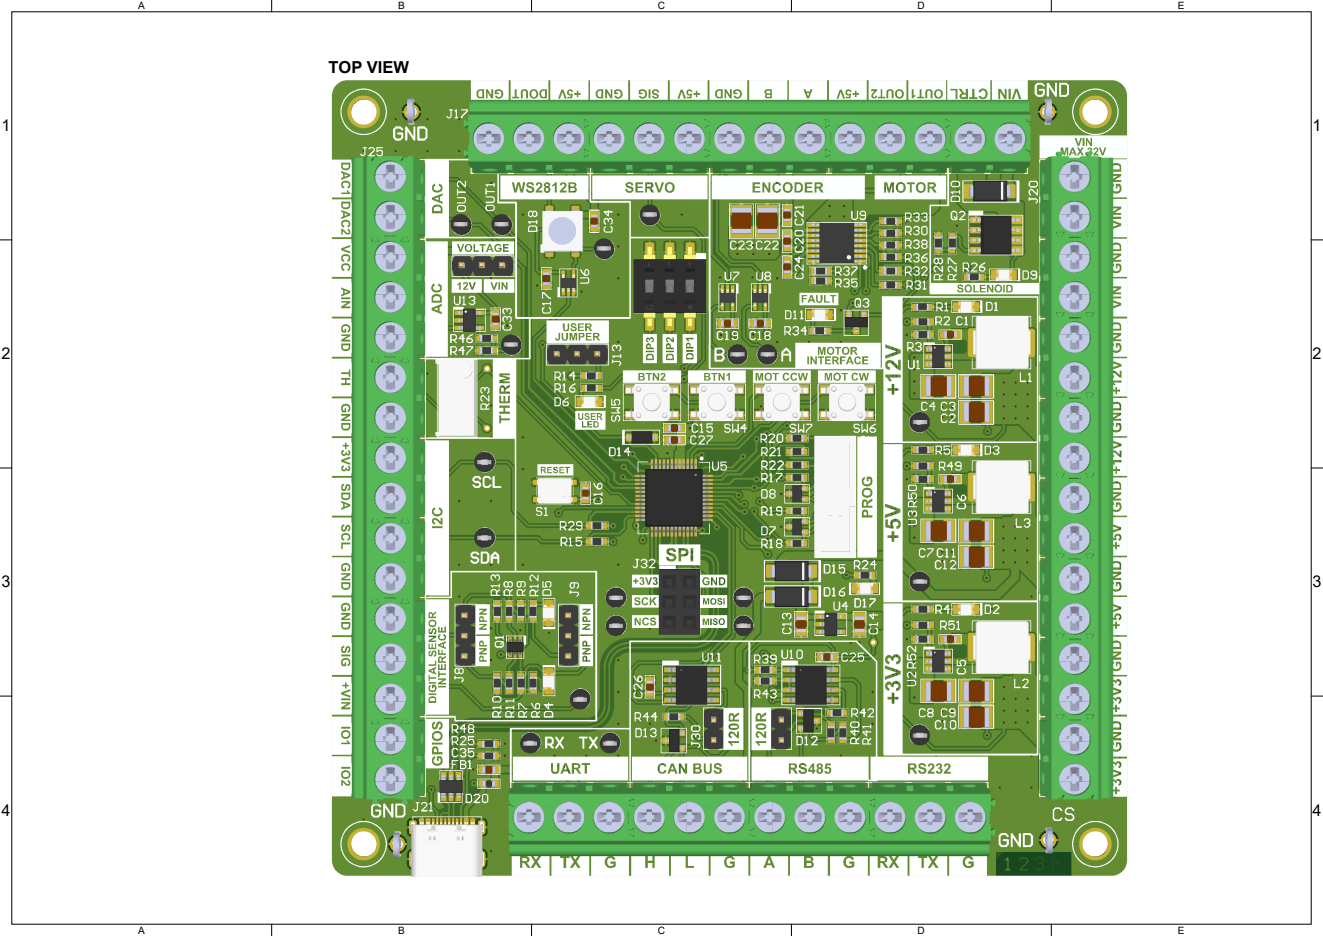
[picture p24: page 1]

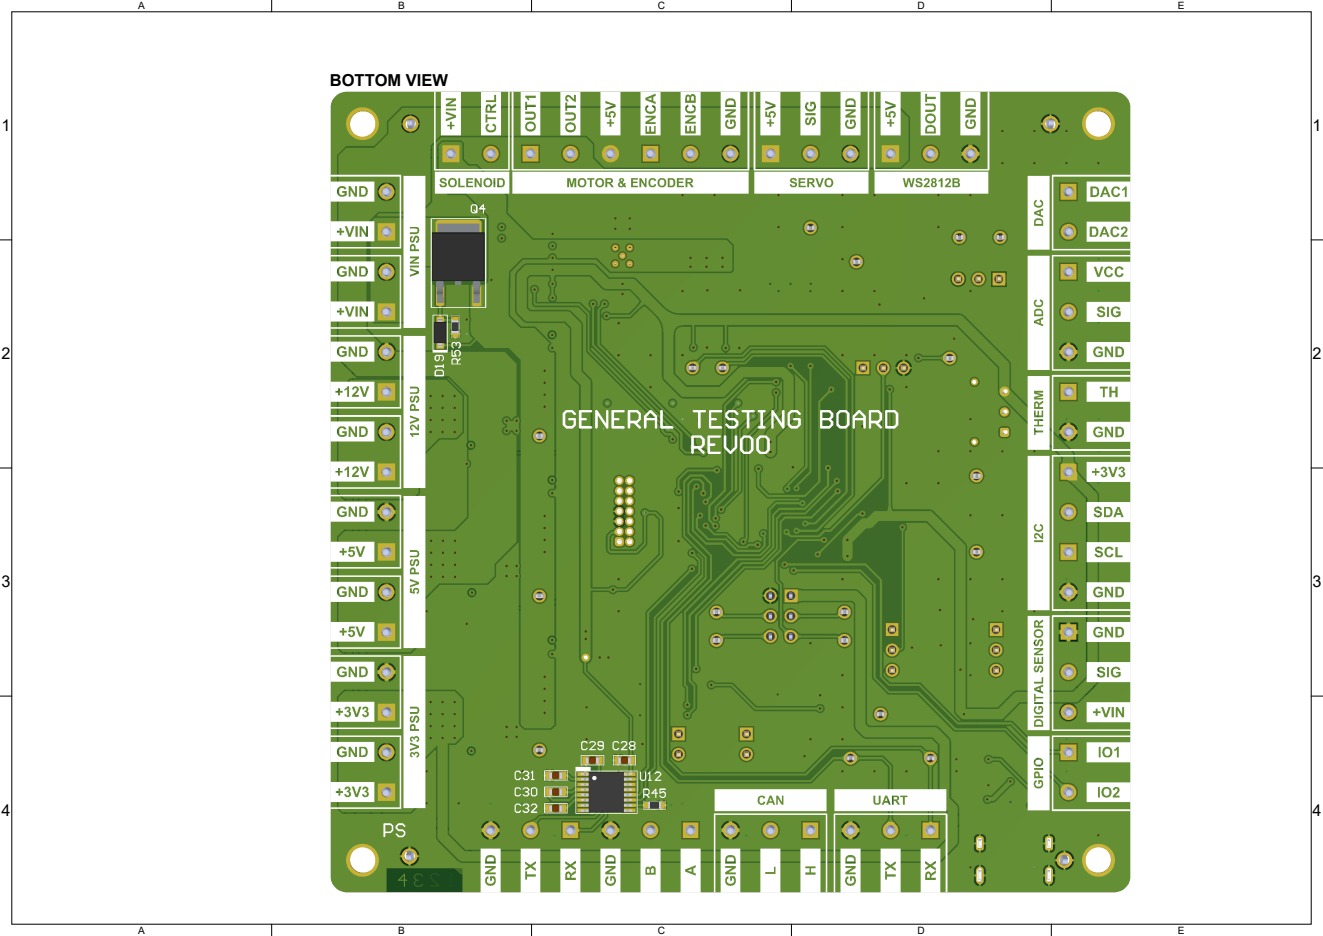
[picture p25: page 2]
