tamirmha/General-Purpose-PCB/Firmware/STM32 Pinout.ioc

Mcu.UserName=STM32G0B1CBTx
PA0.Signal=ADC1_IN0
PA1.Signal=USART2_DE
PA13.Signal=SYS_SWDIO
PA14-BOOT0.Signal=SYS_SWCLK
PA15.GPIO_Label=SERVO_SIG
PA15.Signal=S_TIM2_CH1_ETR
PA2.Signal=USART2_TX
PA3.Signal=USART2_RX
PA4.Signal=COMP_DAC11_group
PA5.Signal=COMP_DAC12_group
PA6.GPIO_Label=WS2812B_SIG
PA6.Signal=S_TIM3_CH1
PA7.GPIO_Label=SOLENOID_SIG
PA7.Signal=S_TIM14_CH1
PA8.GPIO_Label=ENC_A
PA8.Signal=S_TIM1_CH1
PA9.GPIO_Label=ENC_B
PA9.Signal=S_TIM1_CH2
PB0.GPIO_Label=DIGITAL_SENS
PB0.Signal=GPIO_Input
PB1.GPIO_Label=THERMISTOR
PB1.Signal=ADC1_IN9
PB10.Signal=I2C2_SCL
PB11.Signal=I2C2_SDA
PB12.GPIO_Label=SPI_NCS
PB12.Signal=GPIO_Output
PB13.Signal=SPI2_SCK
PB14.Signal=SPI2_MISO
PB15.Signal=SPI2_MOSI
PB2.Signal=ADC1_IN10
PB3.GPIO_Label=DIP1
PB3.Signal=GPIO_Input
PB4.GPIO_Label=BTN1
PB4.Signal=GPIO_Input
PB5.GPIO_Label=BTN2
PB5.Signal=GPIO_Input
PB6.Signal=USART1_TX
PB7.Signal=USART1_RX
PB8.GPIO_Label=MOTOR_PWM
PB8.Signal=S_TIM16_CH1
PB9.GPIO_Label=MOTOR_DIR
PB9.Signal=GPIO_Output
PC13.GPIO_Label=PCB_LED
PC13.Signal=GPIO_Output
PC6.GPIO_Label=IO2
PC6.Signal=GPIO_Output
PC7.GPIO_Label=IO1
PC7.Signal=GPIO_Output
PD0.Signal=FDCAN1_RX
PD1.Signal=FDCAN1_TX
PD2.Signal=USART5_RX
PD3.Signal=USART5_TX
