tamirmha/General-Purpose-PCB/Examples/ex3a_motor_fixed.c

#include "example_config.h"
#ifdef EX_3A_MOTOR_FIXED

#include "main.h"

extern TIM_HandleTypeDef htim16;

void Run_Example(void) {
    
    HAL_TIM_PWM_Start(&htim16, TIM_CHANNEL_1);
    
    while(1) {

        if (HAL_GPIO_ReadPin(MOTOR_CW_GPIO_Port, MOTOR_CW_Pin) == GPIO_PIN_RESET) {
            // Spin Clockwise at ~50% Power
            HAL_GPIO_WritePin(MOTOR_DIR_GPIO_Port, MOTOR_DIR_Pin, GPIO_PIN_RESET);
            __HAL_TIM_SET_COMPARE(&htim16, TIM_CHANNEL_1, 3198);

        } else if (HAL_GPIO_ReadPin(MOTOR_CCW_GPIO_Port, MOTOR_CCW_Pin) == GPIO_PIN_RESET) {
            // Spin Counter-Clockwise at ~50% Power
            HAL_GPIO_WritePin(MOTOR_DIR_GPIO_Port, MOTOR_DIR_Pin, GPIO_PIN_SET);
        	__HAL_TIM_SET_COMPARE(&htim16, TIM_CHANNEL_1, 3198);

        } else {
            // Stop the motor
            __HAL_TIM_SET_COMPARE(&htim16, TIM_CHANNEL_1, 0);
        }

        HAL_Delay(50);
    }
}

#endif // EX_3A_MOTOR_FIXED
