tamirmha/General-Purpose-PCB/(commit log)

2026-01-15 Initial Upload
    [BOM_JLCPCB_PCB.xlsx, BOM_PCBWAY_PCB.xlsx, Pick_Place_JLCPCB_PCB.csv]
2026-01-15 Add README for STM32G0 Development Board projectfix readme
    Added comprehensive documentation for the STM32G0 development board, including project description, components, usage instructions, and credits.
2026-04-04 Enhance sponsors section with detailed acknowledgment
    Expanded the sponsors section to include additional praise for PCBWay's services and support.
2026-04-04 Add PCB images to README.md
    Added images of the PCB and updated the README structure.
2026-04-09 Add: examples
    [CubeMX_Config.txt]
2026-04-11 check examples 1-5, 10-11,13
    [CubeMX_Config.txt]
2026-04-15 update examples
    [CubeMX_Config.txt]
2026-04-26 add: ws2812 multi leds. add:thermistor
