tamirmha/General-Purpose-PCB/images/20260401_105220.jpg

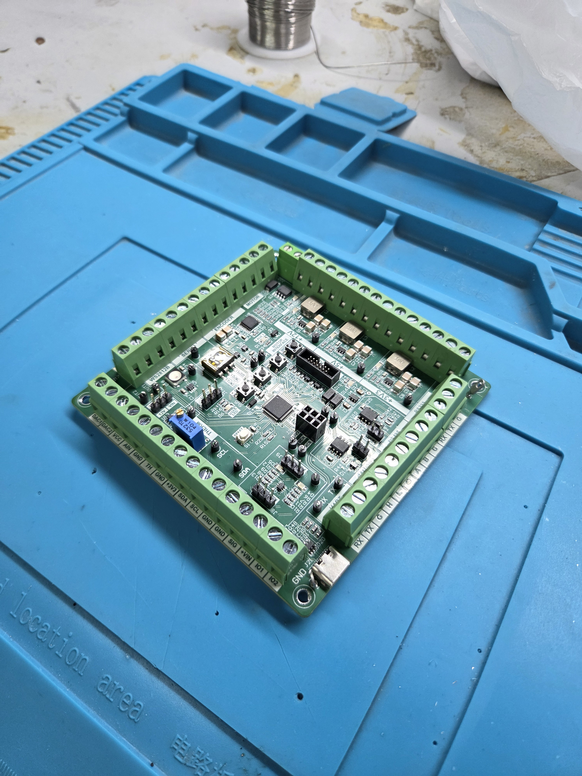
images/20260401_105220.jpg
