tamirmha/General-Purpose-PCB/images/20260401_105217.jpg

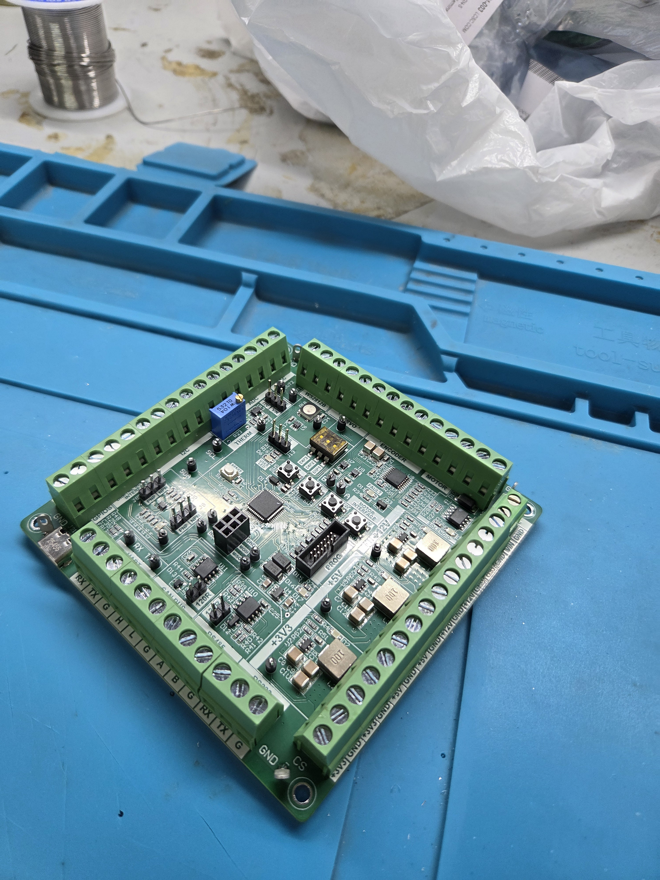
[picture p1: images/20260401_105217.jpg]
images/20260401_105217.jpg
