tamirmha/General-Purpose-PCB/images/20260401_105236.jpg

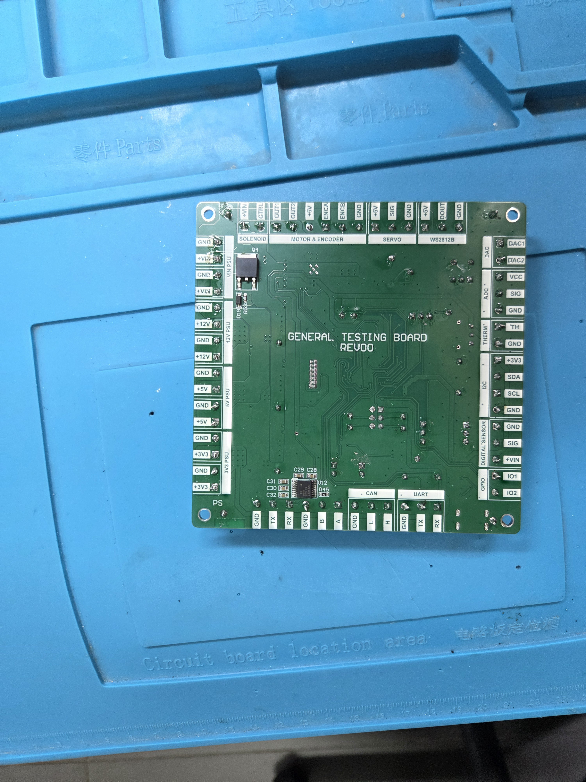
[picture p6: images/20260401_105236.jpg]
images/20260401_105236.jpg
